huayuliang/TEMP_FILE/PannelInterface/GerberFiles_PIb/PannelInterface.png

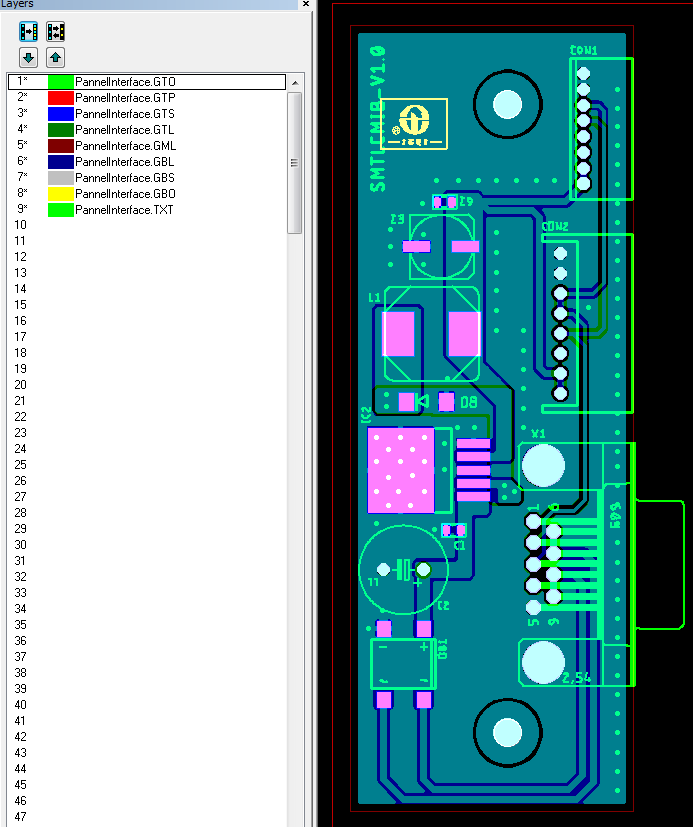
PannelInterface/GerberFiles_PIb/PannelInterface.png
