huayuliang/TEMP_FILE/BOM/BOM - 触摸屏转接适配板.xlsx

 | 造雪机触摸屏转接适配板 |  |  |  | 编制 | 花玉良 |  | 产品编号
 |  |  |  |  | 版本 | V1 |  | 产品名称
 |  |  |  |  | 日期 | 2017-10-12 |  | 产品型号 | SMTLCMIB
 |  |  |  |  | 客户
内部编号 | 零件名称 | 元件代号 | 型号、规格 | 封装 | 数量 | 单位 | 品牌 | 单价 | 备注
焊接物料 |  |  |  |  | 1 | 套
 | 表贴元件
 | 多层陶瓷电容 | C1、C9 | 100n/50V | C0805 | 2 | 个
 | 贴片电解电容 | C3 | 330uF/16V | 8X10 | 1 | 个
 | 整流桥 | DB1 | DB207S | DBS | 1 | 个
 | 功率电感 | L1 | 330uH/2A | RH127 | 1 | 个
 | 肖特基二极管 | D8 | SS24 | DO214AA | 1 | 个
 | DC/DC转换 | IC1 | LM2575D2T-012 | DDPAK-5 | 1 | 个
 | 直插元件
 | 电解电容 | C2 | 470uF/35V | 11x17 | 1 | 个
 | PH 连接器 | CON1 | PH-8AW 2.0mm 90度 8P | PH-8AW | 1 | 个
 | XH 连接器 | CON2 | XH-8AW 2.54mm 90度 8P | XH-8AW | 1 | 个
组装物料 |  |  |  |  | 1 | 套
 | PCB | SMTLCMIB | 36mm*100mm |  | 1 | pcs
 | 螺钉 |  | M3*··长度待定，缺资料 |  | 2 | 个
 |  |  |  |  |  | 个
 |  |  |  |  |  | 个
 |  |  |  |  |  | 个
