huayuliang/TEMP_FILE/BOM/BOM - 造雪机主控板.xlsx

 | 造雪机主控板 |  |  |  | 编制 | 花玉良 |  | 产品编号
 |  |  |  |  | 版本 | V1 |  | 产品名称
 |  |  |  |  | 日期 | 2017-10-12 |  | 产品型号 | SMMB
 |  |  |  |  | 客户
内部编号 | 零件名称 | 元件代号 | 型号、规格 | 封装 | 数量 | 单位 | 品牌 | 单价 | 备注
焊接物料 |  |  |  |  | 1 | 套
 | 表贴元件
 | 贴片多层陶瓷电容 | C1 | 1nF/2kV | C1206 | 1 | 个
 | 贴片多层陶瓷电容 | C4、C5 | 6.8nF/50V | C0603 | 2 | 个
 | 贴片多层陶瓷电容 | C8 | 22nF/50V | C0603 | 1 | 个
 | 贴片多层陶瓷电容 | C39、C44 | 6.8pF/50V/NP0 | C0603 | 2 | 个
 | 贴片多层陶瓷电容 | C27、C22、C47、C48 | 18pF/50V/NP0 | C0603 | 4 | 个
 | 贴片多层陶瓷电容 | C115、C116、C117、C118、C134、C135、C136、C137、C149、C150、C151、C152 | 30pF/50V | C0603 | 12 | 个
 | 贴片多层陶瓷电容 | C120、C121、C122、C123、C138、C139、C140、C141、C155、C156、C157、C158 | 1nF/50V | C0603 | 12 | 个
 | 贴片多层陶瓷电容 | C6、C15、C49、C50、C51、C52、C53、C54、C55、C56、C60、C61、C62、C63、C64、C65、C66、C67、C69、C70、C71、C72、C73、C74、C75、C76、C78、C79、C80、C81、C83、C84、C85、C86、C87、C88、C89、C90、C91、C93、C94、C95、C96、C97、C98、C99、C100、C101、C103 | 10nF/50V | C0603 | 49 | 个
 | 贴片多层陶瓷电容 | C2、C3、C9、C10、C11、C16、C17、C18、C24、C25、C26、C28、C29、C32、C33、C34、C35、C36、C37、C38、C43、C40、C41、C45、C46、C57、C58、C59、C68、C77、C104、C119、C127、C106、C108、C110、C111、C112、C113、C114、C129、C130、C131、C132、C133、C142、C145、C146、C147、C148、C153 | 100nF/50V | C0603 | 51 | 个
 | 贴片多层陶瓷电容 | C13 | 4.7uF/10V | C0603 | 1 | 个
 | 贴片多层陶瓷电容 | C7、C23、C30、C42、C105、C124、C154、C143 | 10uF/16V | C0603 | 8 | 个
 | 贴片铝电解 5X5 | C102、C144、C159、C125 | 47uF/6.3V 5x5.8 | UD-5X5,8_NICHICON | 4 | 个
 | 贴片铝电解 5X5 | C14、C12、C19、C20、C21、C31、C82、C92 | 100uF/6.3V 5x5.8 | UD-5X5,8_NICHICON | 8 | 个
 | 贴片铝电解 8X10 | EC1、EC2、EC3 | 220uF/50V | UD-8X10_NICHICON | 3 | 个
 | 贴片电阻 | R1、R18、R19、R20、R22 | 0R | R1206 | 5 | 个
 | 贴片电阻 | R10 | 10R | R0603 | 1 | 个
 | 贴片电阻 | R2、R5 | 22R | R0603 | 2 | 个
 | 贴片电阻 | R7、R8、R9、R11 | 49R9 | R0603 | 4 | 个
 | 贴片电阻 | R14、R15 | 2.4k | R0603 | 2 | 个
 | 贴片电阻 | R16 | 12.4k/1% | R0603 | 1 | 个
 | 贴片电阻 | R21 | 1M | R0603 | 1 | 个
 | 贴片电阻 | R3、R4、R24、R25、R40、R41、R42、R43、R44、R45、R46、R47、R56、R57、R58、R59、R60、R61、R62、R63、R72、R73、R74、R75、R76、R77、R78、R79 | 330R | R0603 | 11 | 个
 | 贴片电阻 | R34、R170、R171、R172、R173、R195、R196、R197、R198、R219、R220、R221、R222 | 1k | R0603 | 13 | 个
 | 贴片电阻 | R88、R89、R90、R91、R92、R93、R94、R95、R100、R101、R102、R103、R104、R105、R106、R107、R112、R113、R114、R115、R116、R117、R118、R119、R124、R125、R126、R127、R128、R129、R130、R131、R136、R137、R138、R139、R140、R141、R142、R143 | 2.2k | R1206 | 40 | 个
 | 贴片电阻 | R6、R17、R12、R23、R26、R27、R28、R29、R30、R31、R32、R33、R35、R36、R37、R38、R39、R96、R97、R98、R99、R108、R109、R110、R111、R120、R121、R122、R123、R132、R133、R134、R135、R144、R145、R146、R147、R148、R149、R154、R155、R156、R157、R179、R180、R181、R182、R203、R204、R205、R206 | 10k | R0603 | 51 | 个
 | 贴片电阻 | R48、R49、R50、R51、R52、R53、R54、R55、R64、R65、R66、R67、R68、R69、R70、R71、R80、R81、R82、R83、R84、R85、R86、R87、R174 | 20K | R0603 | 25 | 个
 | 贴片电阻 | R13 | 120R | R1206 | 1 | 个
 | 贴片电阻 | R150、R151、R152、R153、R175、R176、R177、R178、R199、R200、R201、R202 | 120R/0.1% | R1206 | 12 | 个
 | 贴片电阻 | R158、R159、R160、R161、R183、R184、R185、R186、R207、R208、R209、R210 | 5.11k/1% | R0603 | 12 | 个
 | 贴片电阻 | R166、R167、R168、R169、R191、R192、R193、R194、R215、R216、R217、R218 | 1k/1% | R0603 | 12 | 个
 | 贴片电阻 | R162、R163、R164、R165、R187、R188、R189、R190、R211、R212、R213、R214 | 124k/1% | R0603 | 12 | 个
 | 贴片磁珠 | L1、L2、L3、L4、L7 | 600R/100MHz | L0603 | 5 | 个
 | 贴片磁珠 | L5、L6、L10 | 100R/100MHz | L0805 | 3 | 个
 | 贴片电感 | L8、L9、L11、L12 | 10uH | L0603 | 4 | 个
 | 0805 贴片 LED | LED1 | 红色 0805 LED | LED0805 | 1 | 个
 |  | LED2、LED3 | 绿色 0805 LED | LED0805 | 2 | 个
 | 晶振 | XTAL1 | 25MHz | SM49 | 1 | 个
 | 晶振 | XTAL2 | MC-306 32.768000kHz 12.5 +20.0-20.0 | MC306 | 1 | 个
 | 晶振 | XTAL3 | 8MHz | SM49 | 1 | 个
 | TVS 管 | D1 | SM712-02H | SOT23-3 | 1 | 个
 | 开关二极管 | D2、D3、D4、D5、D6、D7、D8、D9、D10、D11、D12、D13、D14、D15、D16、D17、D18、D19、D20、D21、D23、D24、D25、D26、D27、D28、D29、D30、D32、D33、D34、D35 | 1N4148 | MINI_MELF(LL-34) | 32 | 个
 | 整流二极管 | D22、D31 | 1N4007 | SMA-DO214AC | 2 | 个
 | 贴片整流桥 | DB2 | KBP2005G | KBP2005 | 1 | 个
 | 四通道光耦 | OK1、OK2、OK3、OK4、OK5、OK6、OK7、OK8、OK9、OK10、OK11 | TLP283-4 | MINI-FLAT-16 | 11 | 个
 | RS232 收发 IC | IC1 | ST3232BD | SO16 | 1 | 个
 | RS485 收发 IC | IC2 | ST3485EBD | SO08 | 1 | 个
 | 以太网 IC | IC3 | W5500 | LQFP48_7X7_0.5P | 1 | 个
 | 实时时钟 IC | IC4 | SD2068 | SOIC-8 | 1 | 个
 | MCU | IC5 | STM32F103VCT6 | LQFP100_14X14MM | 1 | 个
 | 多路达林顿驱动IC | IC6、IC7、IC8 | ULN2803 | SO18W | 3 | 个
 | 基准电压源IC | IC9 | LM4040AIM3X-2.5 | SOT23-3 | 1 | 个
 | 3.3V稳压IC | IC10 | LM1117IDTX-3.3 | TO-252/DPAK | 1 | 个
 | R2R 四运放 | IC11、IC13、IC14、IC15 | SGM8584XS14 | SOIC-14 | 4 | 个
 | 蓝牙模块 | U1 | LQ-BTM2540 | LQ-BTM2540 | 1 | 个 | 蓝讯科技
 |  |  |  |  |  | 个
 | 直插元件
 | 24V 线性稳压IC | IC12 | LM78M24 | TO-220 | 1 | 个
 | 直插铝电解电容 | C109 | 220uF/16V_M10*16 | E3 | 1 | 个
 | 直插铝电解电容 | C107 | 1000uF/16V_M10*16 | E3 | 1 | 个
 | 直插铝电解电容 | C128 | 1000uF/35V_M10*16 | E3 | 1 | 个
 | 直插铝电解电容 | C126 | 2200uF/50V_M16*25 | E7 | 1 | 个
 | 120mA PPTC 保险丝 | F1、F2 | TRF250-120T |  | 2 | 个
 | 1A PPTC 保险丝 | F3、F4、F5 | RXEF110 |  | 3 | 个
 | TO-220 散热器（含螺丝） | HS1 | 23mm * 16.5mm * 30mm |  | 1 | 套
 | 电池 | BAT1 | CR2032/1HF | CR2032-HF | 1 | 个
 | 带变压器 RJ45 座 | CON1 | HR951180A |  | 1 | 个
 | 4Pin 排针 | CON2 | 4Pin 2.54mm 单排针 | PH2.54-4P | 1 | 个
 | 26Pin 牛角座 | CON3 | 26Pin 牛角座 | 26V | 1 | 个
 | DB9 母座 | X1 | SUB-D 母座 9P 180度 | F09VP | 1 | 个
 | 2Pin 绿色弹簧端子 | XT1、XT3、XT4 | FFKDS/V1-5.08-2 | FFKDS/V1-5.08-2 | 3 | 个
 | 2Pin 绿色弹簧端子 | XT2 | FFKDS/V1-5.08-3 | FFKDS/V1-5.08-3 | 1 | 个
 | 2Pin 绿色弹簧端子 |  | FFKDS/V1-5.08-24 | FFKDS/V1-5.08-24 | 1 | 个
 | 2Pin 绿色弹簧端子 |  | FFKDS/V1-5.08-12 | FFKDS/V1-5.08-12 | 2 | 个
 | 2Pin 绿色弹簧端子 |  | FFKDS/V1-5.08-40 | FFKDS/V1-5.08-40 | 1 | 个
组装物料 |  |  |  |  | 1 | 套
 | PCB | SMMB | 315mm*100mm |  | 1 | 个
70607030 | 自攻螺丝 |  | M3X16 |  | 3 | 个
70105006 | 绿色底板 |  | 宽度108.2mm 长315-2-2mm |  | 0.31 | 米
70608009 | 挡片(左) |  | 宽度108.2mm |  | 1 | 个
70608010 | 挡片(右) |  | 宽度108.2mm |  | 1 | 个
 | 控制变压器（需定制） |  | 输入电压：220V/380V；输出：绕组 1：5V/1A；绕组 2：24V/1.2A；绕组3：12V/1.2A |  | 1 | 个
 | 蓝牙天线及转接线 |  |  |  | 1 | 套 | 蓝讯科技
指定蓝讯科技
蓝牙模块链接：https://item.taobao.com/item.htm?spm=a1z10.3-c.w4002-12280541666.20.63236620KxYdoA&id=526084133471
蓝牙天线及转接线链接：https://item.taobao.com/item.htm?spm=2013.1.0.0.412946db8S2JxI&id=43386521334&tracelogww=ltckbburl
变压器不限厂家
变压器定制链接：https://item.taobao.com/item.htm?spm=a1z0d.7625083.1998302264.5.2df65bec2A1MDs&id=521838085399 或类似定制
