huayuliang/TEMP_FILE/snowmaker/SnowMaker_V1.0.pdf

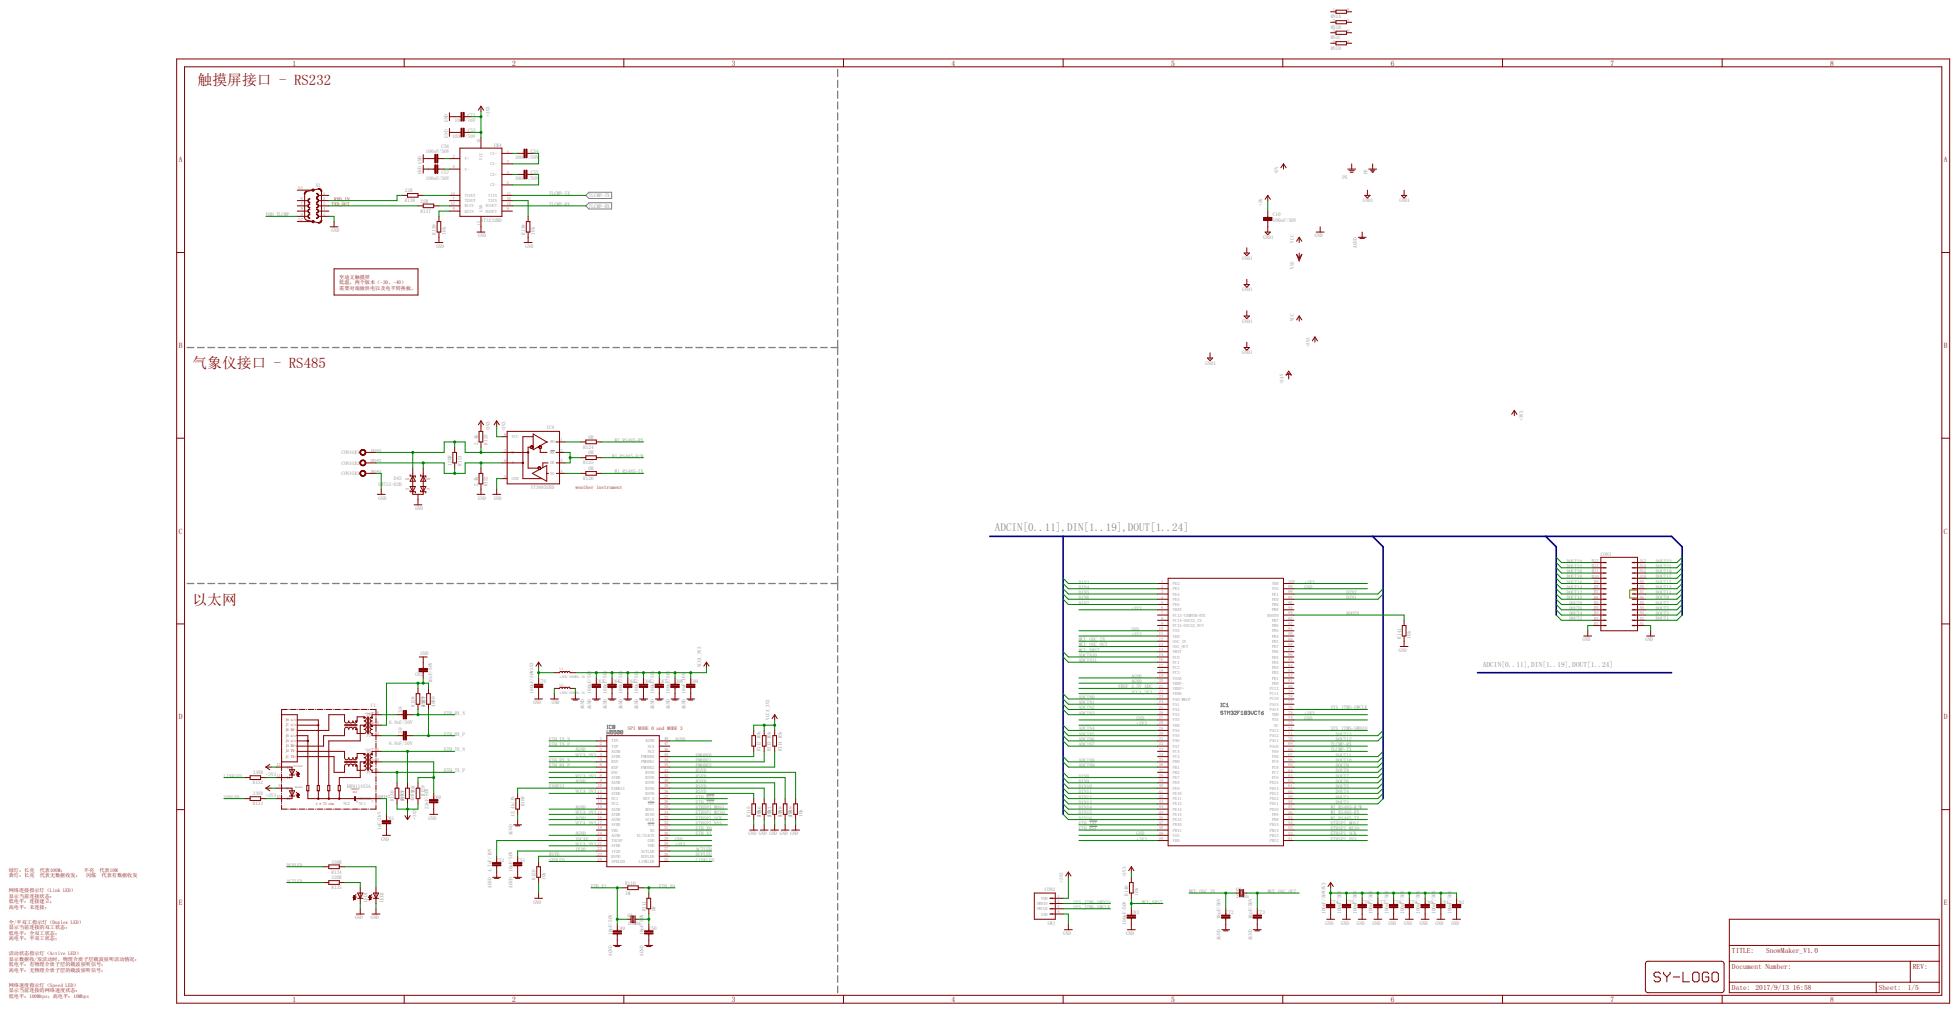
[picture p2: page 1]

VCCA_3V3 GND1 PE GND1 GND1 GND1 GND1 GND1 GND1 +3V3 VCC GND PE +24V 100nF/50V GND1 +5V HR911105A VSS VCC AGND AGND 12.4k/1% AGND 18pF/50V AGND AGND 18pF/50V 1M 0R 10nF/50V AGND 4.7uF/10V AGND 10k 10k 10k 10k GND GND GND GND GND 10k 10k 10k 10k 10k GND GND +3V3 120R ST3485EBD GND 2.4k 2.4k GND +3V3 SM712-02H GND 0R0R0R GND +3V3 6.8nF/50V 6.8nF/50V 22nF/50V 1nF/2kV GND 49R9 49R9 10R 49R9 10nF/50V GND 49R9 GND 330R 330R 330R +3V3 +3V3 330R GND GND 120R/100MHz 3A VCCA_3V3 100nF/50V AGND 100nF/50V AGND 100nF/50V AGND 100nF/50V AGND 100nF/50V AGND 100nF/50V AGND 10uF/16V AGND 100nF/50V+3V3 GND 25MHz 18pF/50V AGND AGND 18pF/50V25MHz 100nF/50V+3V3 GND 100nF/50V GND 100nF/50V GND 100nF/50V GND 100nF/50V GND 100nF/50V GND 100nF/50V GND 100nF/50V GND 100nF/50V GND 10k 100nF/50V GND +3V3 SWJ GND +3V3 10k GND 120R/100MHz 3A ST3232BD GND +3V3 +3V3 G100nF/50V ND 100nF/50V 100nF/50V 100nF/50V 100nF/50V GND GND 22R 22R 10k 10k GND GND G10uF/16V ND +5V GND GND GND PE2 1 PE3 2 PE4 3 PE5 4 PE6 5 VBAT 6 PC13-TAMPER-RTC 7 PC14-OSC32_IN 8 PC15-OSC32_OUT 9 VSS 10 VDD 11 OSC_IN 12 OSC_OUT 13 NRST 14 PC0 15 PC1 16 PC2 17 PC3 18 VSSA 19 VREF- 20 VREF+ 21 VDDA 22 PA0-WKUP 23 PA1 24 PA2 25 PA3 26 VSS 27 VDD 28 PA4 29 PA5 30 PA6 31 PA7 32 PC4 33 PC5 34 PB0 35 PB1 36 PB2 37 PE7 38 PE8 39 PE9 40 PE10 41 PE11 42 PE12 43 PE13 44 PE14 45 PE15 46 PB10 47 PB11 48 VSS 49 VDD 50 PB12 51 PB13 52 PB14 53 PB15 54 PD8 55 PD9 56 PD10 57 PD11 58 PD12 59 PD13 60 PD14 61 PD15 62 PC6 63 PC7 64 PC8 65 PC9 66 PA8 67 PA9 68 PA10 69 PA11 70 PA12 71 PA13 72 NC 73 VSS 74 VDD 75 PA14 76 PA15 77 PC10 78 PC11 79 PC12 80 PD0 81 PD1 82 PD2 83 PD3 84 PD4 85 PD5 86 PD6 87 PD7 88 PB3 89 PB4 90 PB5 91 PB6 92 PB7 93 BOOT0 94 PB8 95 PB9 96 PE0 97 PE1 98 VSS 99 VDD 100 C10 TXN 1 TXP 2 AGND 3 AVDD 4 RXN 5 RXP 6 DNC 7 AVDD 8 AGND 9 EXRES1 10 AVDD 11 NC1 12 NC2 13 AGND 14 AVDD 15 AGND 16 AVDD 17 VBG 18 AGND 19 TOCAP 20 AVDD 21 1V2O 22 RSVD 23 SPDLED 24 LINKLED 25 DUPLED 26 ACTLED 27 VDD 28 GND 29 XI/CLKIN 30 XO 31 SCS 32 SCLK 33 MISO 34 MOSI 35 INT 36 RST_N 37 RSVD 38 RSVD 39 RSVD 40 RSVD 41 RSVD 42 PMODE2 43 PMODE1 44 PMODE0 45 NC3 46 NC4 47 AGND 48 U1 P6 6 P5 5 P3 3 P2 2 P4 4 P1 1 SHIELD SS@1*2 10 10 9 9 11 11 12 12 NC1 7 NC2 8 R109 C49 C50 R110 R111 C52 C51 RN1A 1 8 RN1B 2 7 RN1C 3 6 RN1D 4 5 R112 R113 R114 R115 R116 R117 R118 R119 R120 R121 IC9 B 7 A 6 GND 5 VCC 8 RO 1 RE 2 DE 3 DI 4 CON1G$1 1@1*2 CON1G$2 2@1*2 CON1G$3 3@1*2 R122 R123 D45 R124 R125 R126 C58 C59 C60 C61 R127 R128 R129 R130 C62 R131 R132 R133 R134 R135 L1 C70 C63 C64 C65 C66 C67 C68 C69 LED1 LED2 Q1 C72 C73 Q2 C74 C75 C76 C77 C78 C79 C80 C81 C82 R140 C83 CON2 VDD 1 SWDIO 2 SWCLK 3 GND 4 R141 L2 U$4 C1+ 1 C1- 3 C2+ 4 C2- 5 T1IN 11 T2IN 10 R1OUT 12 R2OUT 9 V+ 2 V- 6 T1OUT 14 T2OUT 7 R1IN 13 R2IN 8 VCC 16 GND 15 C53 C54 C55 C56 C57 X1 1 6 2 7 3 8 4 9 5 G1G2 R136 R137 R138 R139 C71 CON3 A1A2A3A4A5 B1B2B3B4B5 A6A7A8A9A10 B6B7B8B9 B10 A11 A12 A13 B11 B12 B13 ADCIN[0..11],DIN[1..19],DOUT[1..24] ADCIN[0..11],DIN[1..19],DOUT[1..24] ETH_INT ETH_INT ETH_RST ETH_RST GND GND GNDGND GND GND ACTLED ACTLED DUPLED DUPLED LINKLED LINKLED SPDLED SPDLED 1V20 TOCAP PMODE0 PMODE1 PMODE2 AGND AGND AGND AGND AGND AGND AGND AGND EXRES1 +3V3 +3V3 +3V3 +3V3 +3V3 +3V3 +3V3 RSVD RSVD RSVD RSVD RSVD RSVD WI_RS485-R/W WI_RS485-R/W ETH_TX_P ETH_TX_P ETH_TX_N ETH_TX_N VCCA_3V3 VCCA_3V3 VCCA_3V3 VCCA_3V3 VCCA_3V3 VCCA_3V3 VCCA_3V3 ETH_RX_N ETH_RX_N ETH_RX_P ETH_RX_P ADCIN0 ADCIN1 ADCIN2 ADCIN3 ADCIN4 ADCIN5 ADCIN6 ADCIN7 ADCIN8 ADCIN9 ADCIN10 ADCIN11 ETHSPI_MOSI ETHSPI_MOSI ETHSPI_MISO ETHSPI_MISO ETHSPI_SCK ETHSPI_SCK ETHSPI_NSS ETHSPI_NSS VREF_2.5V_ADC ETH_XO ETH_XO ETH_XI ETH_XI MCU_OSC_IN MCU_OSC_IN MCU_OSC_OUT MCU_OSC_OUT MCU_NRST MCU_NRST SYS_JTMS-SWCLK SYS_JTMS-SWCLK DOUT2 DOUT2 DOUT3 DOUT3 DOUT4 DOUT4 DOUT5 DOUT5 DOUT7 DOUT7 DOUT8 DOUT8 DOUT9 DOUT9 DOUT10 DOUT10 DOUT11 DOUT11 DOUT12 DOUT12 SYS_JTMS-SWDIO SYS_JTMS-SWDIO DOUT6 DOUT6 DOUT13 DOUT13 BOOT0 TLCMP-RX TLCMP-RX TLCMP-RX DOUT1 DOUT14 DOUT16 DOUT15 DOUT18 DOUT17 DOUT20 DOUT19 DOUT22 DOUT21 DOUT24 DOUT23 WI_RS485-TX WI_RS485-TX WI_RS485-RX WI_RS485-RX DIN1 DIN2 DIN3 DIN4 DIN5 DIN6 DIN7 DIN8 DIN9 DIN10 DIN11 DIN12 DIN13 DIN14 DIN15 DIN16 TLCMP-TX TLCMP-TX TLCMP-TX VDD_TLCMP SPI MODE 0 and MODE 3 网络连接指示灯（Link LED） 显示当前连接状态： 低电平：连接建立； 高电平：未连接； 全/半双工指示灯（Duplex LED） 显示当前连接的双工状态： 低电平：全双工状态； 高电平：半双工状态； 活动状态指示灯（Active LED） 显示数据收/发活动时，物理介质子层载波侦听活动情况： 低电平：有物理介质子层的载波侦听信号； 高电平：无物理介质子层的载波侦听信号； 网络速度指示灯（Speed LED） 显示当前连接的网络速度状态： 低电平：100Mbps；高电平：10Mbps 绿灯：长亮 代表100M； 不亮 代表10M 黄灯：长亮 代表无数据收发； 闪烁 代表有数据收发 weather instrument 至迪文触摸屏 低温，两个版本（-30、-40） 需要对端做供电以及电平转换板。 RXD_IN TXD_OUT ABCDE 1 2 3 4 5 6 7 8 ABCDE 1 2 3 4 5 6 7 8 以太网 气象仪接口 - RS485 触摸屏接口 - RS232 1CT:1CT 1CT:1CT J8 n/c J7 n/c J6 RX- J5 n/c J4 n/c J3 RX+ J2 TX- J1 TX+ 4 * 75 ohm Yellow Green 1000pF 2kV R-R+T-T+ RCT TCT 12V 7V 12V 7V Date: 2017/9/13 16:58 Sheet: 1/5REV: TITLE: Document Number: SnowMaker_V1.0

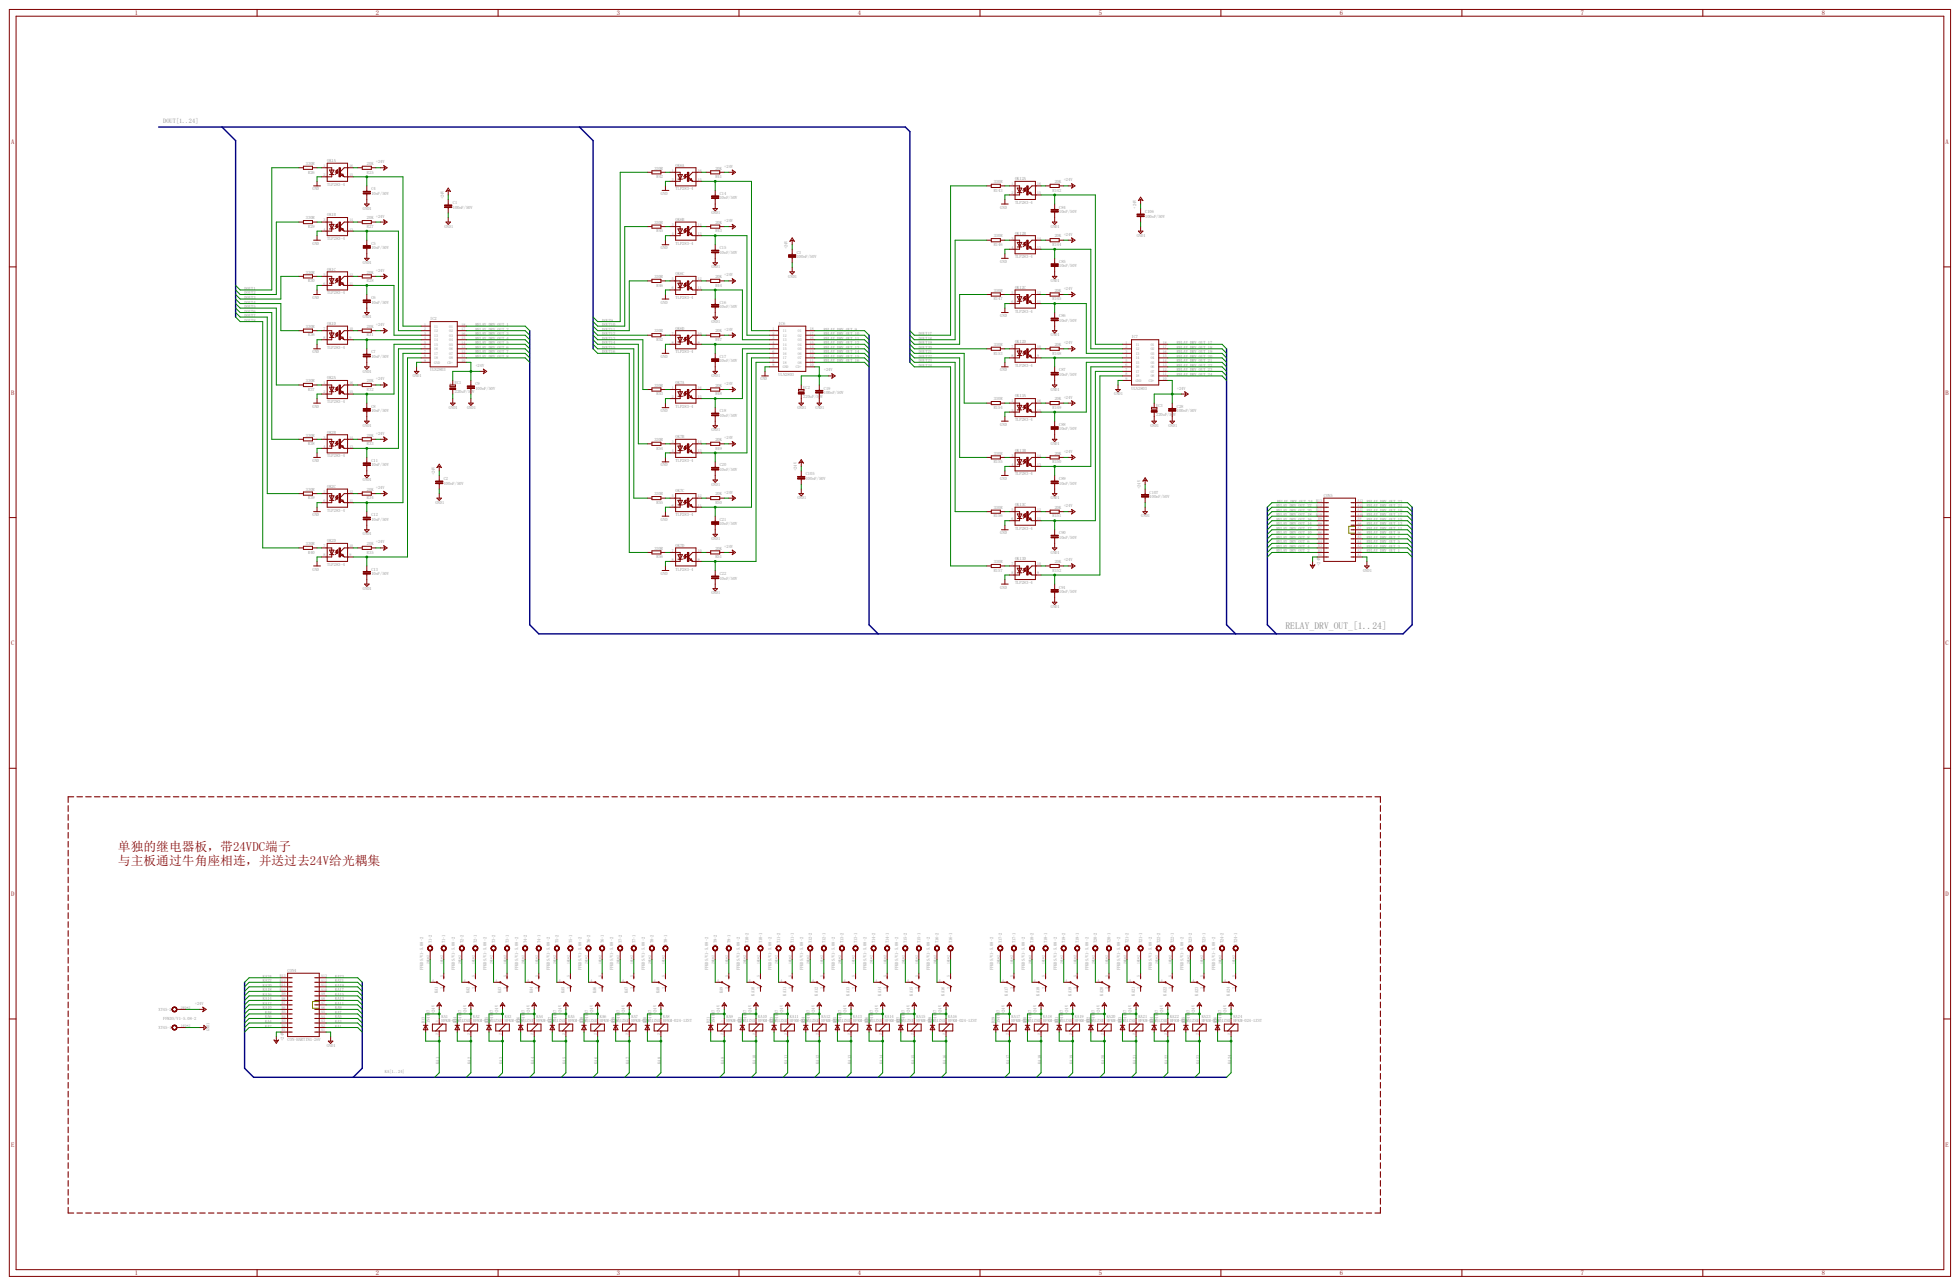
[picture p3: page 2]

RELAY_DRV_OUT_4 B3 RELAY_DRV_OUT_2 B2 | A3 RELAY_DRV_OUT_3 A2 RELAY_DRV_OUT_1

HFKM-024-1ZST HFKM-024-1ZST HFKM-024-1ZST HFKM-024-1ZST

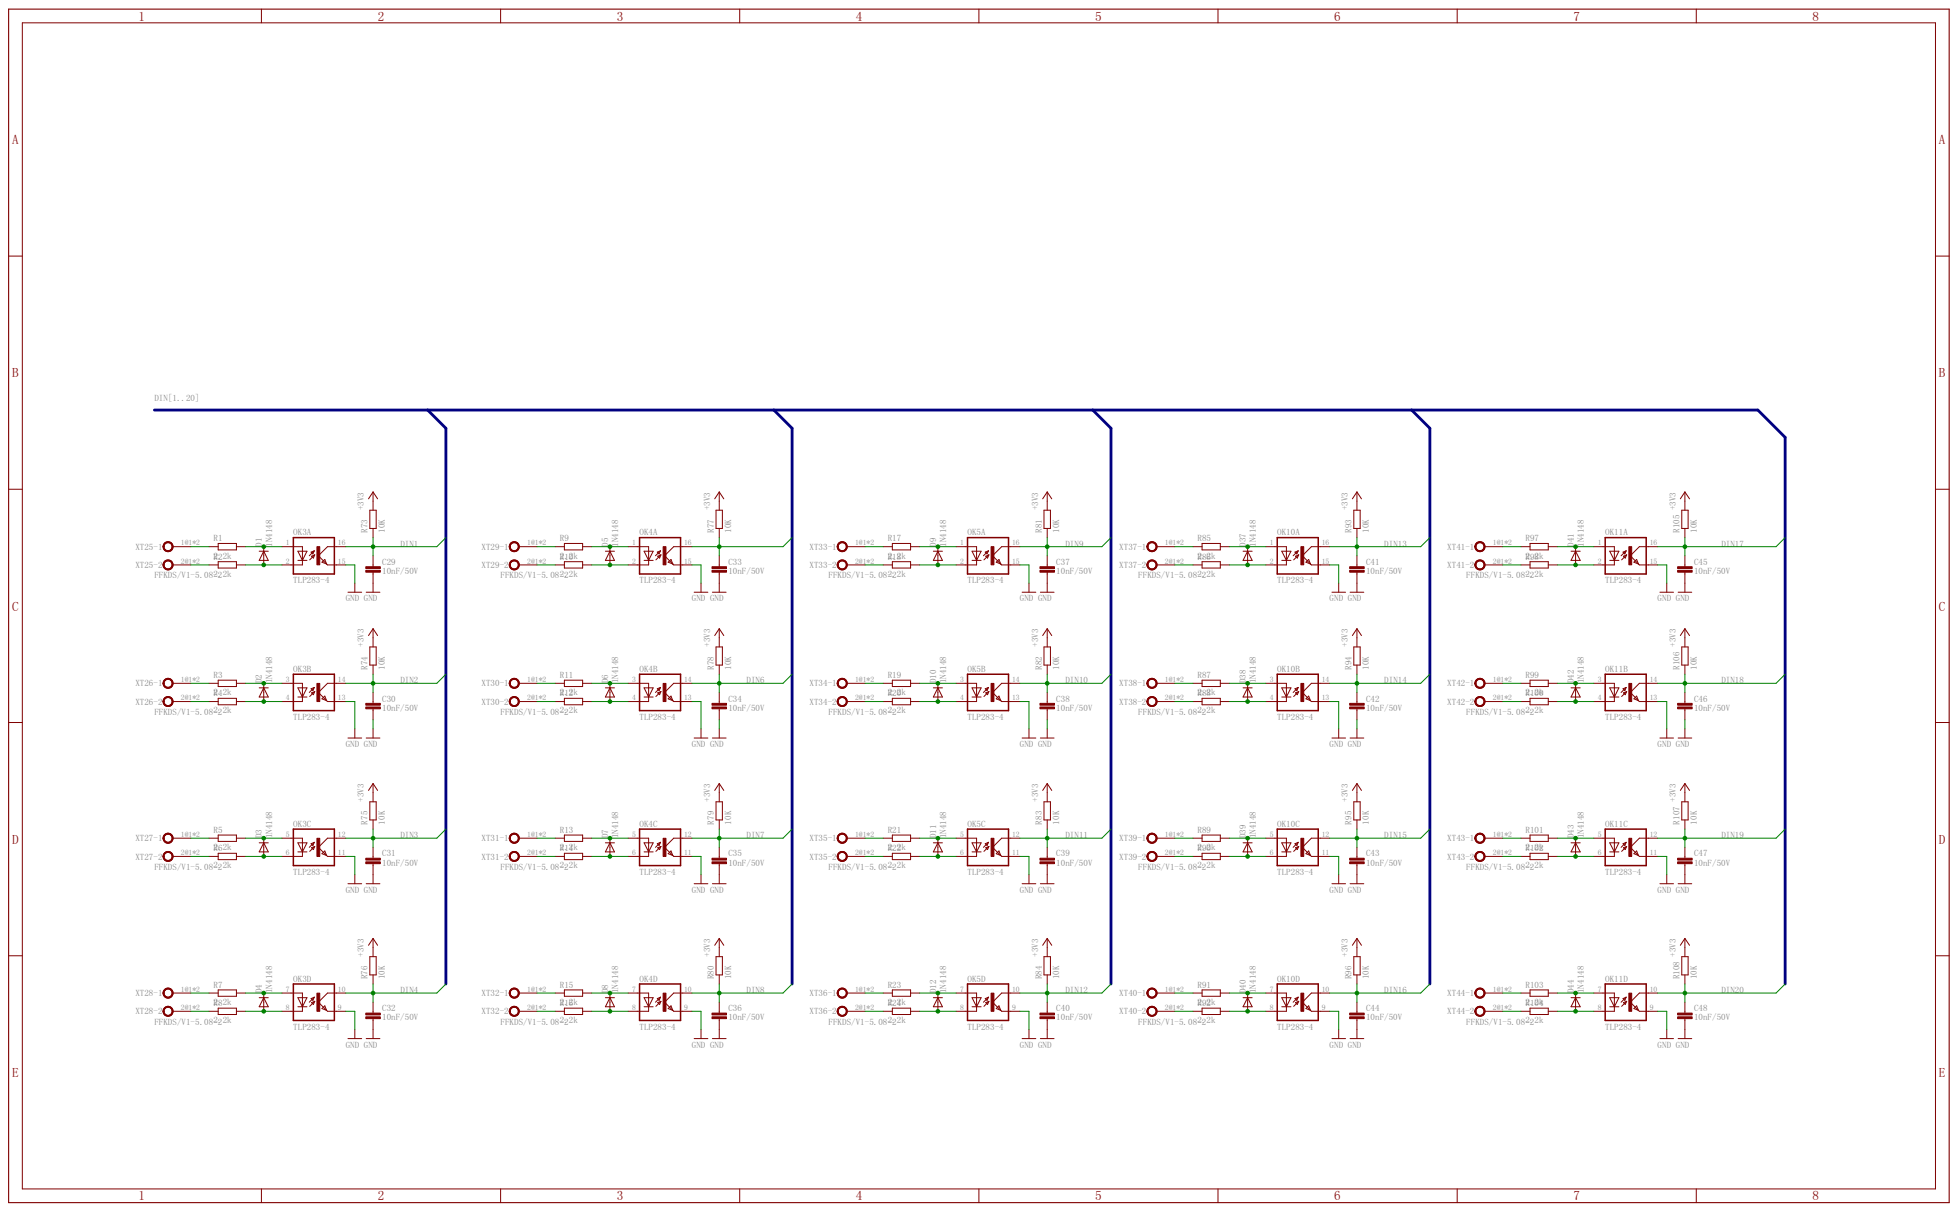
[picture p4: page 3]

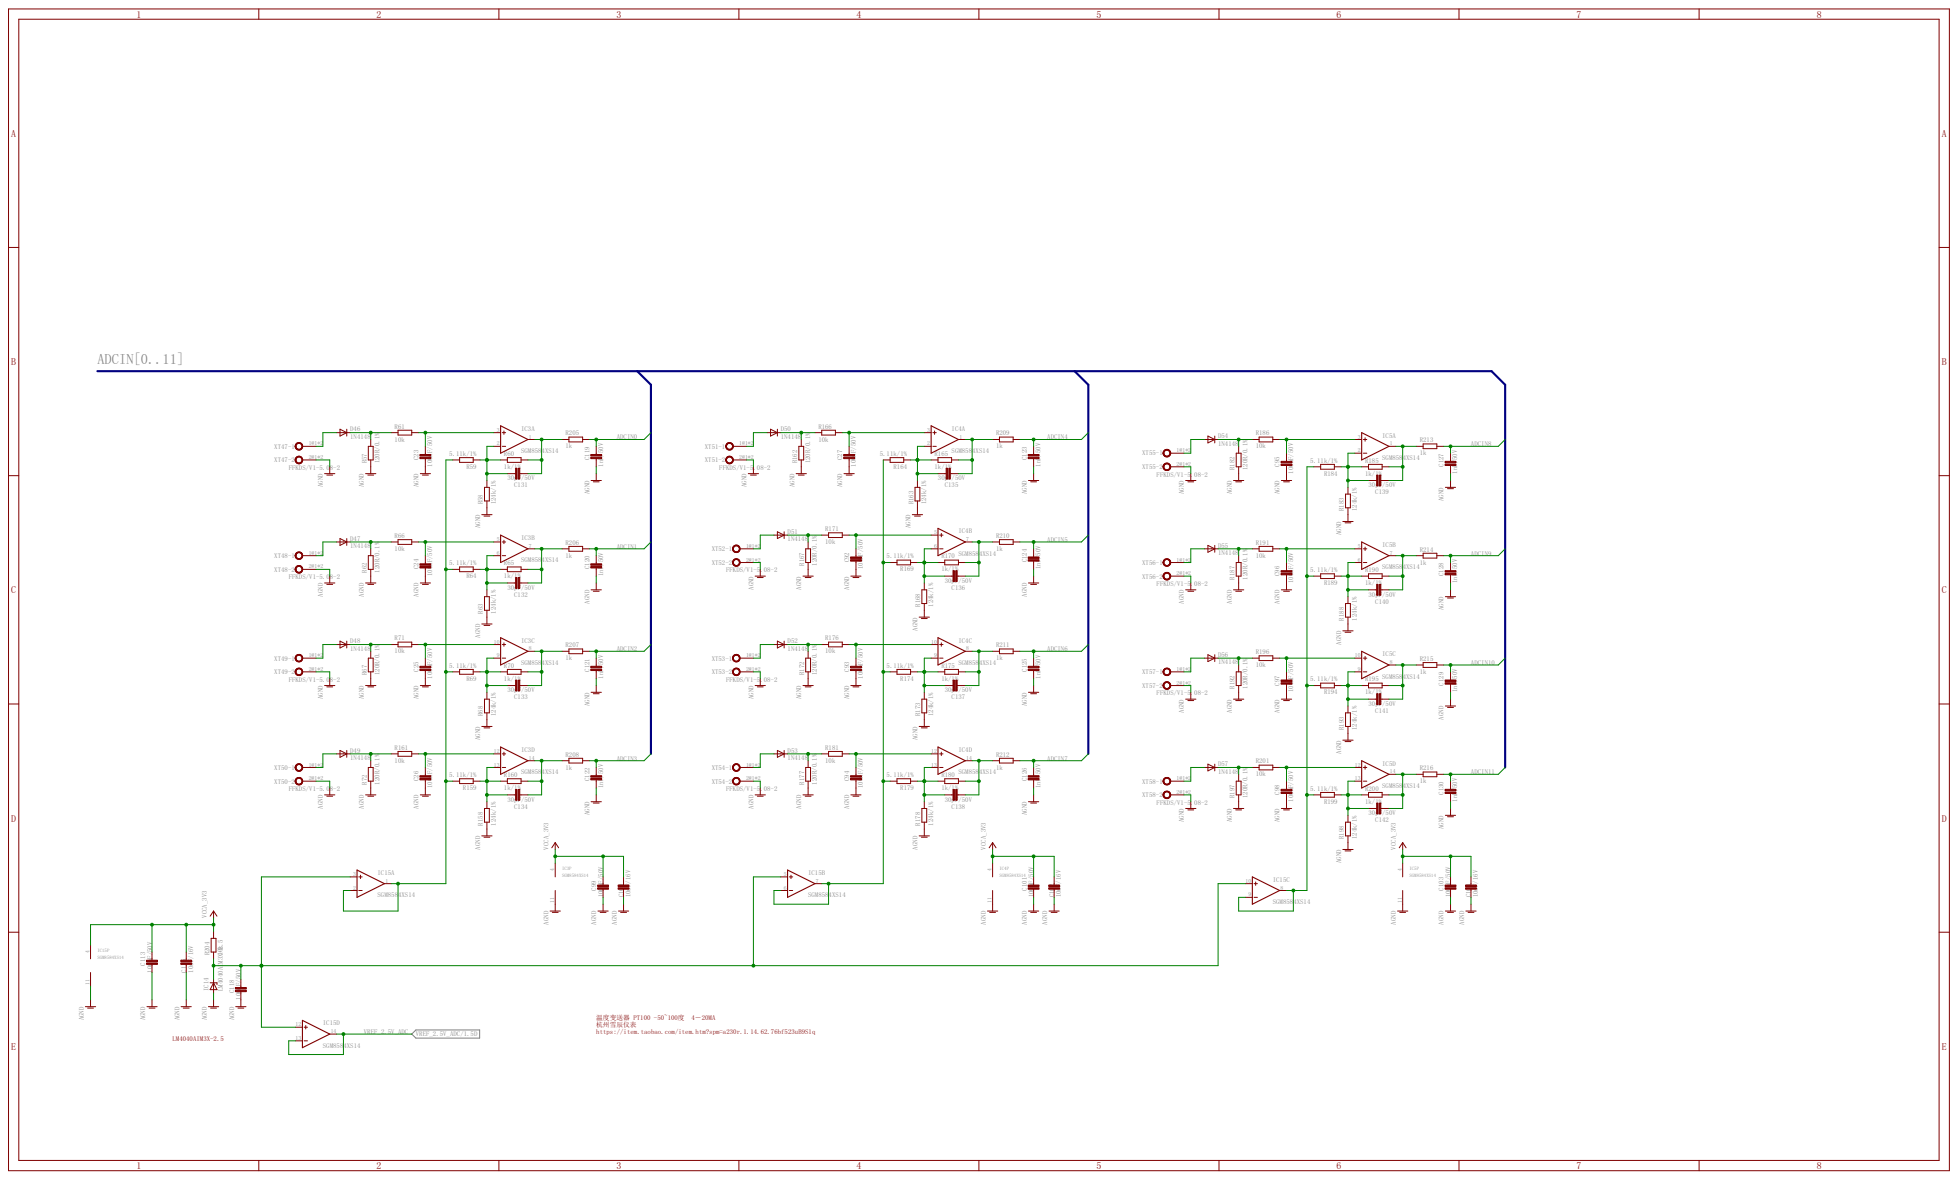
[picture p5: page 4]

https://item.taobao.com/item.htm?spm=a230r.1.14.62.76bf523uB9S1q

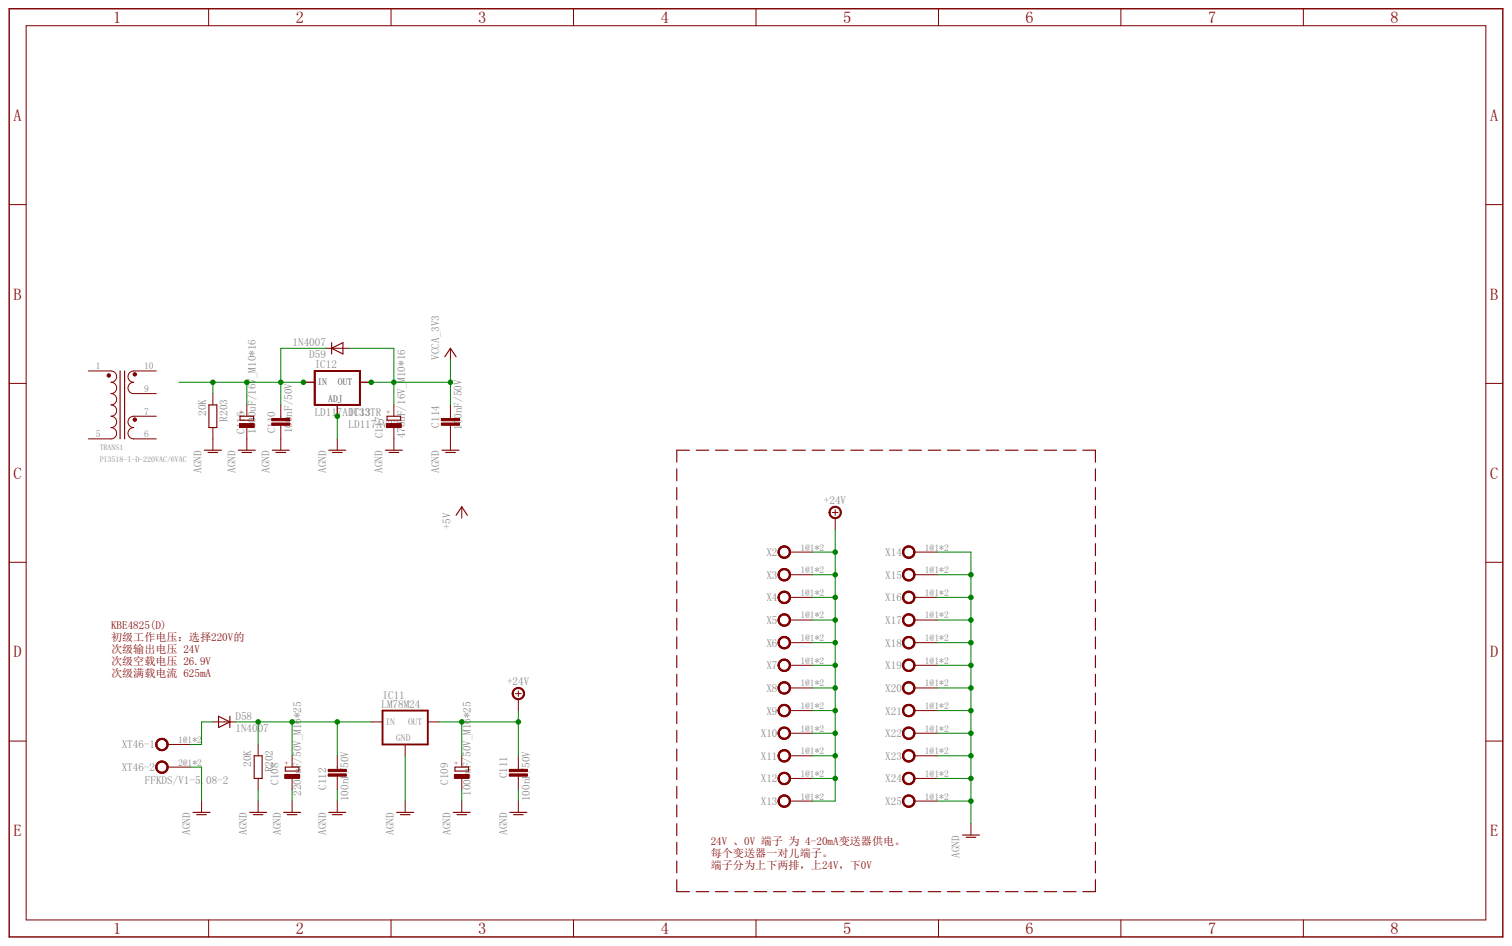
[picture p6: page 5]
