huayuliang/TEMP_FILE/snowmaker/GerberFiles_SnowMakerMainBoard_V1.0/SnowMaker_V1.0.TXT

%
M48
M72
T01C0.01575
T02C0.01772
T03C0.01969
T04C0.02362
T05C0.03200
T06C0.03346
T07C0.03504
T08C0.03600
T09C0.03937
T10C0.04000
T11C0.04016
T12C0.04331
T13C0.04724
T14C0.05118
T15C0.06417
T16C0.12598
T17C0.13000
%
T01
X70462Y163681
X72462Y167681
X70462Y171681
X76462Y171681
X78462Y167681
X81462Y163681
X85462Y163681
X89462Y164681
X84462Y167681
X81462Y171681
X85462Y173681
X90824Y170681
X90824Y177681
X80089Y183681
X77106Y181326
X73277Y181496
X73132Y177352
X75462Y163681
X134462Y172681
X446462Y240681
X456462Y239681
X466462Y239681
X476462Y239681
X486462Y239681
X520462Y245681
X546462Y240181
X550462Y247181
X559182Y251401
X562562Y253360
X566337Y253244
X567737Y257019
X569137Y260794
X570537Y264569
X573256Y267188
X576087Y264681
X577112Y260681
X578512Y256906
X598462Y256181
X599462Y252209
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
