huayuliang/TEMP_FILE/snowmaker/GerberFiles_SnowMakerMainBoard_V1.0/SnowMaker_V1.0.png

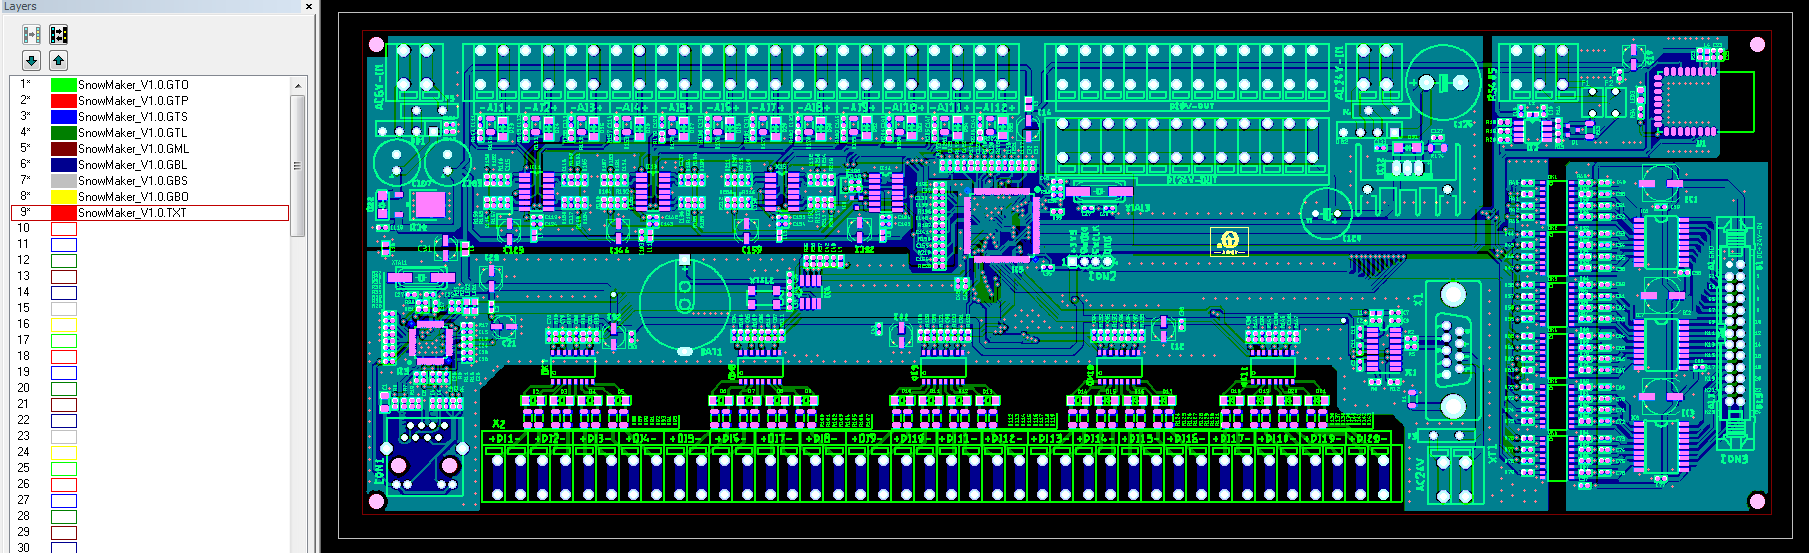
snowmaker/GerberFiles_SnowMakerMainBoard_V1.0/SnowMaker_V1.0.png
