huayuliang/TEMP_FILE/SnowMaker_RelayBoard/GerberFilse_SMRB-V1/SMRB-V1.png

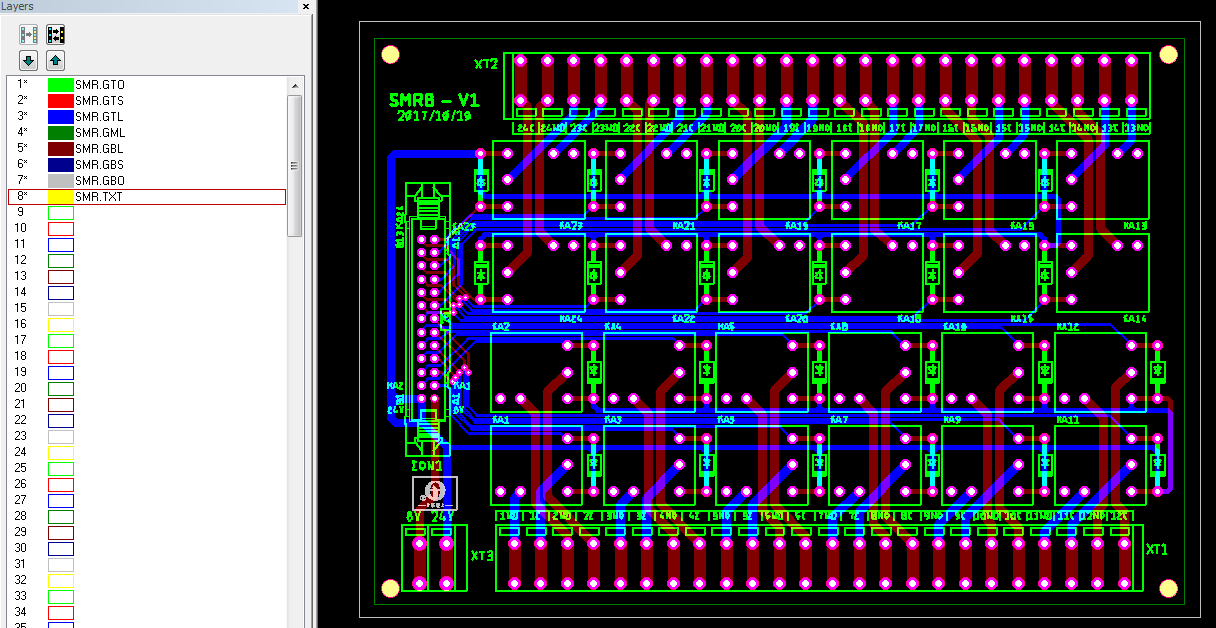
SnowMaker_RelayBoard/GerberFilse_SMRB-V1/SMRB-V1.png
