huayuliang/TEMP_FILE/DevTool/devtool.brd

## EAGLE design DevTool/devtool.brd (2017-10-18)

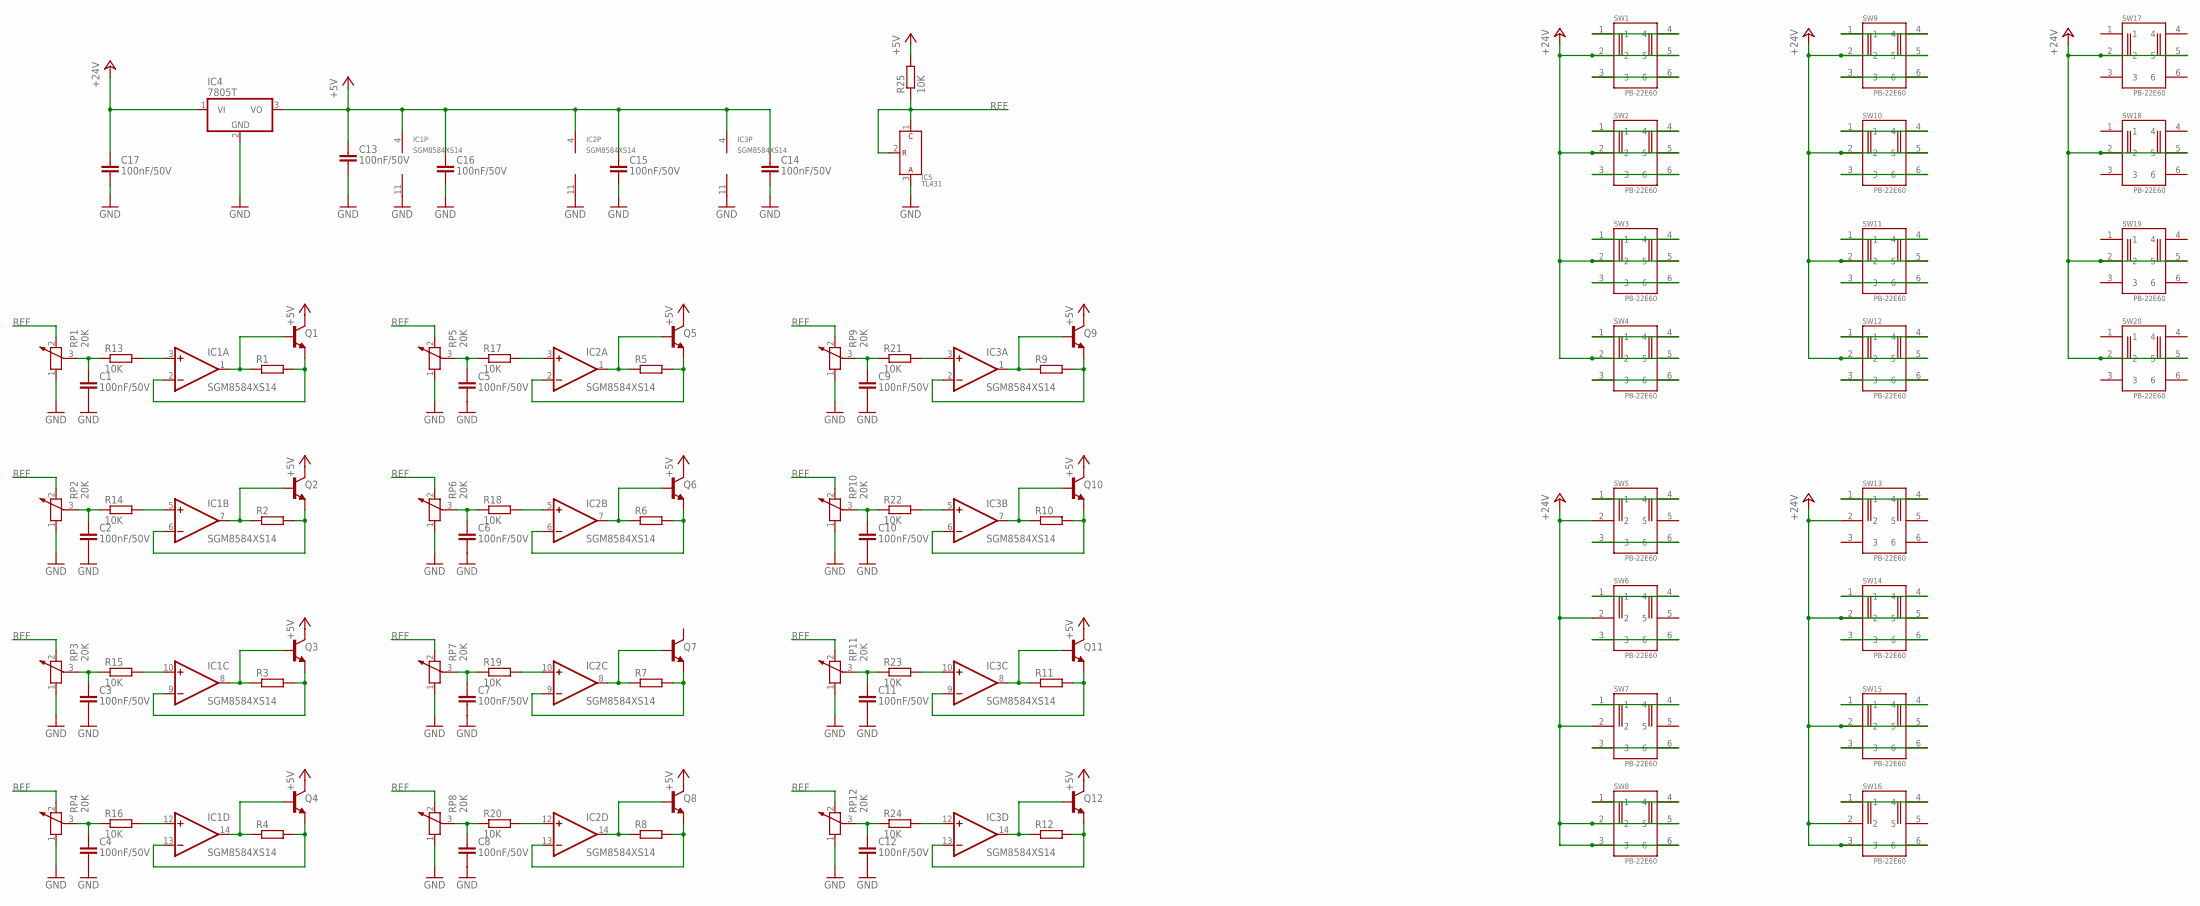
[picture p11: schematic devtool.sch]

Parts:
C1, C2, C3, C4, C5, C6, C7, C8, C9, C10, C11, C12, C13, C14, C15, C16, C17: 100nF/50V; C0603
IC1, IC2, IC3: SGM8584XS14; SOIC-14
IC4: 7805T; TO220H
IC5: TL431; SOT23-3
Q1, Q2, Q3, Q4, Q5, Q6, Q7, Q8, Q9, Q10, Q11, Q12: NPN; SOT23-BEC
R1, R2, R3, R4, R5, R6, R7, R8, R9, R10, R11, R12: R0603
R13, R14, R15, R16, R17, R18, R19, R20, R21, R22, R23, R24, R25: 10K; R0603
RP1, RP2, RP3, RP4, RP5, RP6, RP7, RP8, RP9, RP10, RP11, RP12: 20K; RM065
SW1, SW2, SW3, SW4, SW5, SW6, SW7, SW8, SW9, SW10, SW11, SW12, SW13, SW14, SW15, SW16, SW17, SW18, SW19, SW20: PB-22E60

Connections:
+5V: C13.1, C14.1, C15.1, C16.1, IC1.4 (V+), IC2.4 (V+), IC3.4 (V+), IC4.3 (VO), Q1.C, Q2.C, Q3.C, Q4.C, Q5.C, Q6.C, Q8.C, Q9.C, Q10.C, Q11.C, Q12.C, R25.2
+24V: C17.1, IC4.1 (VI), SW1.2, SW1.5, SW2.2, SW2.5, SW3.2, SW3.5, SW4.2, SW4.5, SW5.2, SW6.2, SW7.2, SW8.2, SW8.3, SW8.5, SW8.6, SW9.2, SW9.5, SW10.2, SW10.5, SW11.2, SW11.5, SW12.2, SW12.5, SW13.2, SW14.2, SW14.5, SW15.2, SW15.5, SW16.2, SW16.3, SW16.6, SW17.2, SW17.5, SW18.2, SW18.5, SW19.2, SW19.5, SW20.2, SW20.5
GND: C1.2, C2.2, C3.2, C4.2, C5.2, C6.2, C7.2, C8.2, C9.2, C10.2, C11.2, C12.2, C13.2, C14.2, C15.2, C16.2, C17.2, IC1.11 (V-), IC2.11 (V-), IC3.11 (V-), IC4.2 (GND), IC5.3 (A), RP1.1, RP2.1, RP3.1, RP4.1, RP5.1, RP6.1, RP7.1, RP8.1, RP9.1, RP10.1, RP11.1, RP12.1
unnamed: SW12.3, SW12.6
unnamed: IC1.1 (OUT), Q1.B, R1.1
unnamed: IC1.7 (OUT), Q2.B, R2.1
unnamed: IC1.8 (OUT), Q3.B, R3.1
unnamed: IC1.14 (OUT), Q4.B, R4.1
unnamed: IC2.1 (OUT), Q5.B, R5.1
unnamed: IC2.7 (OUT), Q6.B, R6.1
unnamed: IC2.8 (OUT), Q7.B, R7.1
unnamed: IC2.14 (OUT), Q8.B, R8.1
unnamed: IC3.1 (OUT), Q9.B, R9.1
unnamed: IC3.7 (OUT), Q10.B, R10.1
unnamed: IC3.8 (OUT), Q11.B, R11.1
unnamed: IC3.14 (OUT), Q12.B, R12.1
unnamed: IC1.2 (-IN), Q1.E, R1.2
unnamed: IC3.13 (-IN), Q12.E, R12.2
unnamed: IC3.9 (-IN), Q11.E, R11.2
unnamed: IC3.6 (-IN), Q10.E, R10.2
unnamed: IC3.2 (-IN), Q9.E, R9.2
unnamed: IC1.6 (-IN), Q2.E, R2.2
unnamed: IC1.9 (-IN), Q3.E, R3.2
unnamed: IC1.13 (-IN), Q4.E, R4.2
unnamed: IC2.2 (-IN), Q5.E, R5.2
unnamed: IC2.6 (-IN), Q6.E, R6.2
unnamed: IC2.9 (-IN), Q7.E, R7.2
unnamed: IC2.13 (-IN), Q8.E, R8.2
unnamed: SW14.3, SW14.6
unnamed: SW14.1, SW14.4
unnamed: SW13.1, SW13.4
unnamed: SW15.1, SW15.4
unnamed: SW15.3, SW15.6
unnamed: SW16.1, SW16.4
unnamed: SW8.1, SW8.4
unnamed: SW7.3, SW7.6
unnamed: SW7.1, SW7.4
unnamed: SW6.3, SW6.6
unnamed: SW6.1, SW6.4
unnamed: SW5.3, SW5.6
unnamed: SW5.1, SW5.4
unnamed: SW4.3, SW4.6
unnamed: SW4.1, SW4.4
unnamed: SW3.1, SW3.4
unnamed: SW3.3, SW3.6
unnamed: SW2.1, SW2.4
unnamed: SW2.3, SW2.6
unnamed: SW1.3, SW1.6
unnamed: SW1.1, SW1.4
unnamed: SW9.1, SW9.4
unnamed: SW9.3, SW9.6
unnamed: SW10.1, SW10.4
unnamed: SW10.3, SW10.6
unnamed: SW11.1, SW11.4
unnamed: SW11.3, SW11.6
unnamed: SW12.1, SW12.4
unnamed: C1.1, R13.1, RP1.3
unnamed: C2.1, R14.1, RP2.3
unnamed: C3.1, R15.1, RP3.3
unnamed: C4.1, R16.1, RP4.3
unnamed: C5.1, R17.1, RP5.3
unnamed: C6.1, R18.1, RP6.3
unnamed: C7.1, R19.1, RP7.3
unnamed: C8.1, R20.1, RP8.3
unnamed: C9.1, R21.1, RP9.3
unnamed: C10.1, R22.1, RP10.3
unnamed: C11.1, R23.1, RP11.3
unnamed: C12.1, R24.1, RP12.3
unnamed: IC1.3 (+IN), R13.2
unnamed: IC1.5 (+IN), R14.2
unnamed: IC1.10 (+IN), R15.2
unnamed: IC1.12 (+IN), R16.2
unnamed: IC2.12 (+IN), R20.2
unnamed: IC2.10 (+IN), R19.2
unnamed: IC2.5 (+IN), R18.2
unnamed: IC2.3 (+IN), R17.2
unnamed: IC3.3 (+IN), R21.2
unnamed: IC3.5 (+IN), R22.2
unnamed: IC3.10 (+IN), R23.2
unnamed: IC3.12 (+IN), R24.2
REF: IC5.1 (C), IC5.2 (REF), R25.1, RP1.2, RP2.2, RP3.2, RP4.2, RP5.2, RP6.2, RP7.2, RP8.2, RP9.2, RP10.2, RP11.2, RP12.2

Board: 2 copper layers, 91 parts (0 on the bottom side), 81 nets, no tracks yet.
