huayuliang/TEMP_FILE/PannelInterface/PannelInterface.brd

## EAGLE design PannelInterface/PannelInterface.brd (2017-10-12)

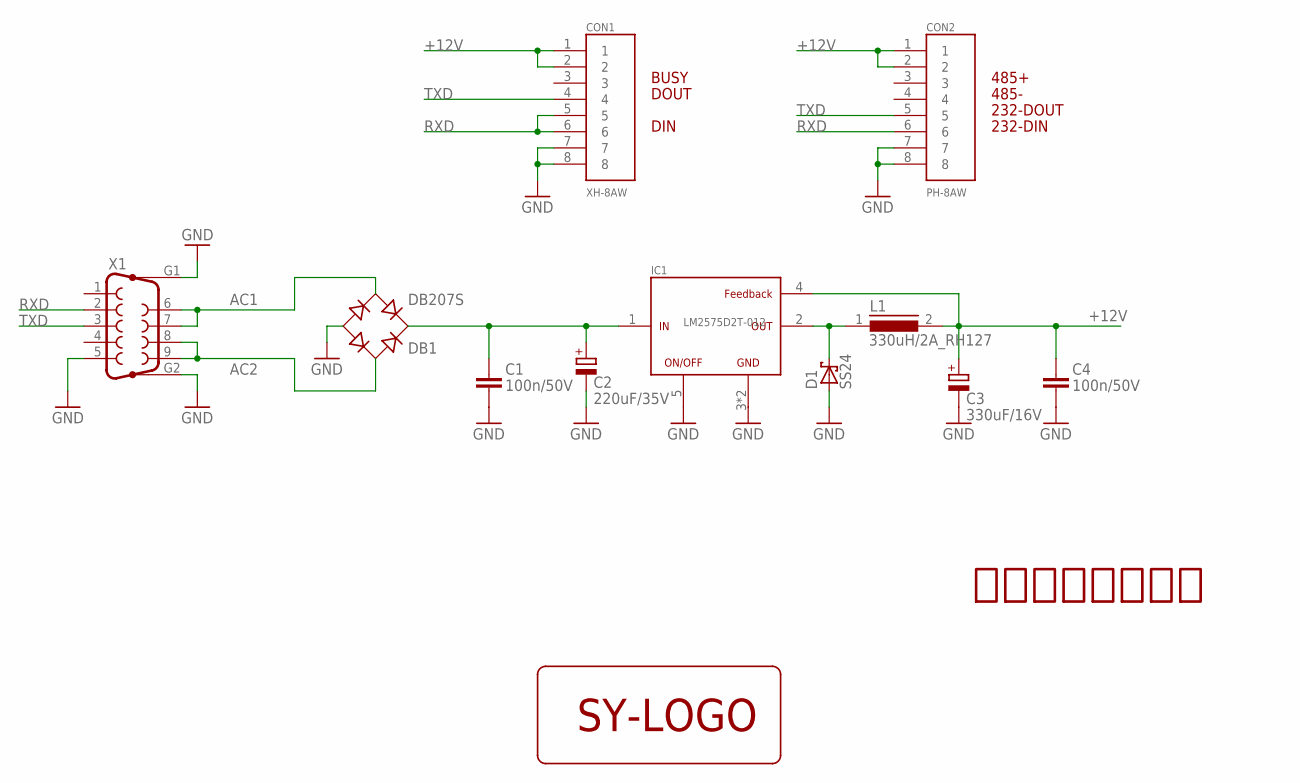
[picture p12: schematic PannelInterface.sch]

Parts:
C1, C4: 100n/50V; C0805
C2: 220uF/35V; TT5D11
C3: 330uF/16V; UD-8X10_NICHICON
CON1: XH-8AW
CON2: PH-8AW
D1: SS24; DO214AA
DB1: DB207S; DBS
IC1: LM2575D2T-012; DDPAK-5_MICROCHIP
L1: 330uH/2A_RH127; MSS1260
LOGO1: SY-LOGO_BOTTOM
X1: F09HP

Connections:
+12V: C3.+, C4.1, CON1.1, CON1.2, CON2.1, CON2.2, IC1.4, L1.2
AC1: DB1.AC2, X1.6, X1.7
AC2: DB1.AC1, X1.8, X1.9
GND: C1.2, C2.-, C3.-, C4.2, CON1.7, CON1.8, CON2.7, CON2.8, D1.A, DB1.-, IC1.3, IC1.5, IC1.6 (3), X1.5, X1.G1, X1.G2
unnamed: C1.1, C2.+, DB1.+, IC1.1
unnamed: D1.C, IC1.2, L1.1
RXD: CON1.5, CON1.6, CON2.6, X1.2
TXD: CON1.4, CON2.5, X1.3

Notes on the sheet:
DIN
DOUT
232-DOUT
232-DIN
485+
485-
BUSY
触摸屏转接适配板

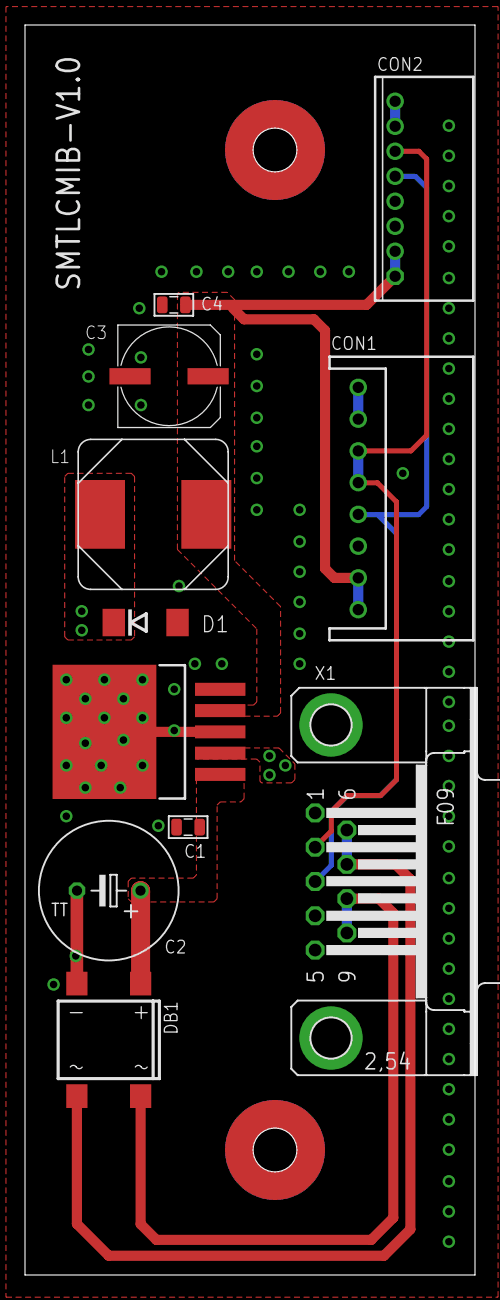
[picture p13: board PannelInterface.brd from above]

Board: 2 copper layers, 36.0 x 100.0 mm, 13 parts (0 on the bottom side), 8 nets.

Other parts of the board:
U$1: PANNEL-INTERFACE-OUTLINE
