huayuliang/TEMP_FILE/SnowMaker_RelayBoard/SMR.brd

## EAGLE design SnowMaker_RelayBoard/SMR.brd (2017-10-10)

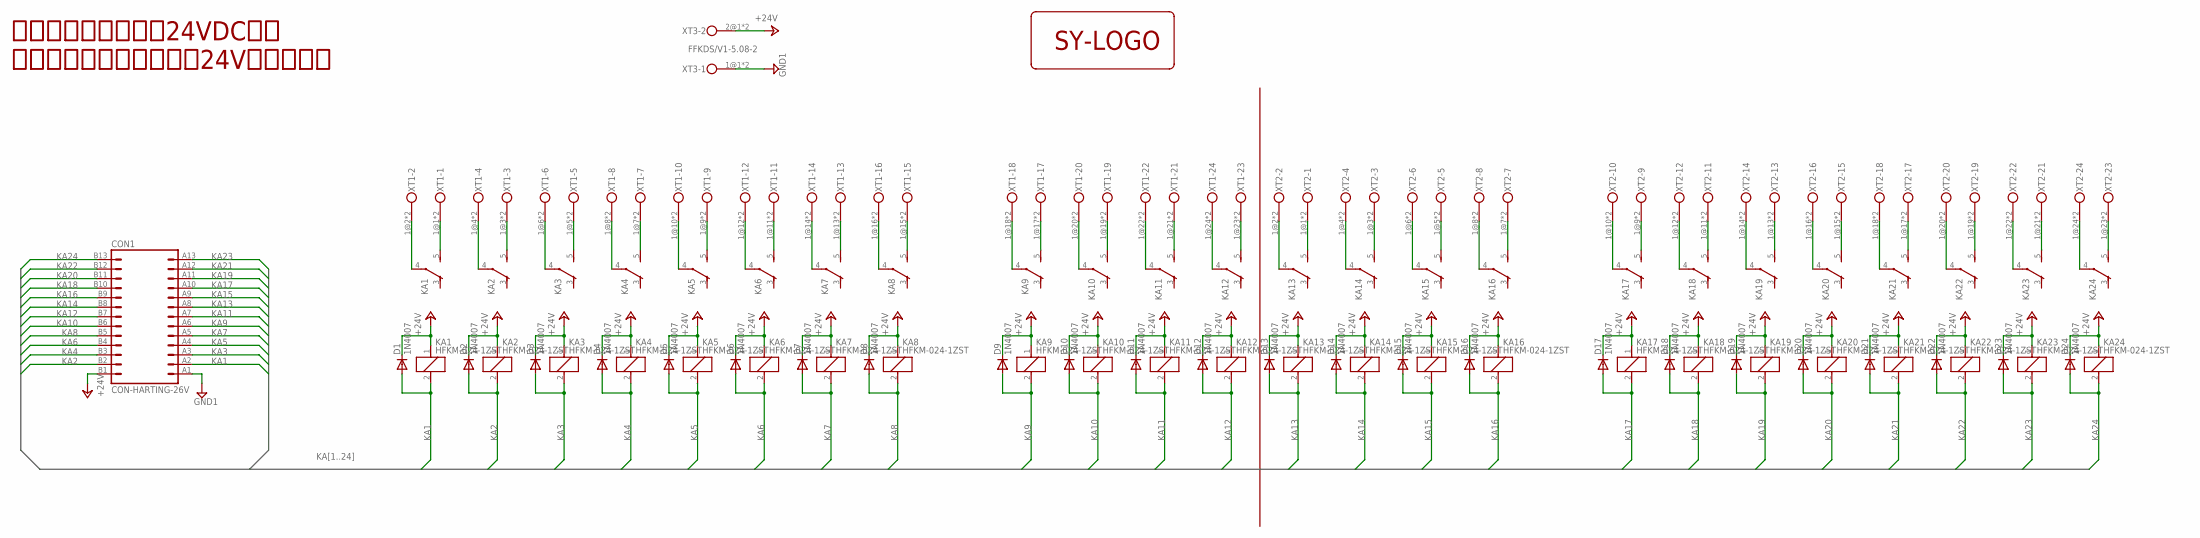
[picture p22: schematic SMR.sch]

Parts:
CON1: CON-HARTING-26V; 26V
D1, D2, D3, D4, D5, D6, D7, D8, D9, D10, D11, D12, D13, D14, D15, D16, D17, D18, D19, D20, D21, D22, D23, D24: 1N4007; DO41-10
KA1, KA2, KA3, KA4, KA5, KA6, KA7, KA8, KA9, KA10, KA11, KA12, KA13, KA14, KA15, KA16, KA17, KA18, KA19, KA20, KA21, KA22, KA23, KA24: HFKM-024-1ZST; HFKM-1ZST
LOGO1: SY-LOGO_BOTTOM
XT1, XT2: FFKDS/V1-5.08-24
XT3: FFKDS/V1-5.08-2

Connections:
+24V: CON1.B1, D1.C, D2.C, D3.C, D4.C, D5.C, D6.C, D7.C, D8.C, D9.C, D10.C, D11.C, D12.C, D13.C, D14.C, D15.C, D16.C, D17.C, D18.C, D19.C, D20.C, D21.C, D22.C, D23.C, D24.C, KA1.1 (COIL1), KA2.1 (COIL1), KA3.1 (COIL1), KA4.1 (COIL1), KA5.1 (COIL1), KA6.1 (COIL1), KA7.1 (COIL1), KA8.1 (COIL1), KA9.1 (COIL1), KA10.1 (COIL1), KA11.1 (COIL1), KA12.1 (COIL1), KA13.1 (COIL1), KA14.1 (COIL1), KA15.1 (COIL1), KA16.1 (COIL1), KA17.1 (COIL1), KA18.1 (COIL1), KA19.1 (COIL1), KA20.1 (COIL1), KA21.1 (COIL1), KA22.1 (COIL1), KA23.1 (COIL1), KA24.1 (COIL1), XT3.2@1, XT3.2@2
GND1: CON1.A1, XT3.1@1, XT3.1@2
KA1: CON1.A2, D1.A, KA1.2 (COIL2)
KA2: CON1.B2, D2.A, KA2.2 (COIL2)
KA3: CON1.A3, D3.A, KA3.2 (COIL2)
KA4: CON1.B3, D4.A, KA4.2 (COIL2)
KA5: CON1.A4, D5.A, KA5.2 (COIL2)
KA6: CON1.B4, D6.A, KA6.2 (COIL2)
KA7: CON1.A5, D7.A, KA7.2 (COIL2)
KA8: CON1.B5, D8.A, KA8.2 (COIL2)
KA9: CON1.A6, D9.A, KA9.2 (COIL2)
KA10: CON1.B6, D10.A, KA10.2 (COIL2)
KA11: CON1.A7, D11.A, KA11.2 (COIL2)
KA12: CON1.B7, D12.A, KA12.2 (COIL2)
KA13: CON1.A8, D13.A, KA13.2 (COIL2)
KA14: CON1.B8, D14.A, KA14.2 (COIL2)
KA15: CON1.A9, D15.A, KA15.2 (COIL2)
KA16: CON1.B9, D16.A, KA16.2 (COIL2)
KA17: CON1.A10, D17.A, KA17.2 (COIL2)
KA18: CON1.B10, D18.A, KA18.2 (COIL2)
KA19: CON1.A11, D19.A, KA19.2 (COIL2)
KA20: CON1.B11, D20.A, KA20.2 (COIL2)
KA21: CON1.A12, D21.A, KA21.2 (COIL2)
KA22: CON1.B12, D22.A, KA22.2 (COIL2)
KA23: CON1.A13, D23.A, KA23.2 (COIL2)
KA24: CON1.B13, D24.A, KA24.2 (COIL2)
unnamed: KA1.4 (COM), XT1.1@2, XT1.2@2
unnamed: KA1.5 (NO), XT1.1@1, XT1.2@1
unnamed: KA3.4 (COM), XT1.1@6, XT1.2@6
unnamed: KA3.5 (NO), XT1.1@5, XT1.2@5
unnamed: KA8.5 (NO), XT1.1@15, XT1.2@15
unnamed: KA8.4 (COM), XT1.1@16, XT1.2@16
unnamed: KA7.5 (NO), XT1.1@13, XT1.2@13
unnamed: KA7.4 (COM), XT1.1@14, XT1.2@14
unnamed: KA6.5 (NO), XT1.1@11, XT1.2@11
unnamed: KA6.4 (COM), XT1.1@12, XT1.2@12
unnamed: KA5.5 (NO), XT1.1@9, XT1.2@9
unnamed: KA5.4 (COM), XT1.1@10, XT1.2@10
unnamed: KA4.5 (NO), XT1.1@7, XT1.2@7
unnamed: KA4.4 (COM), XT1.1@8, XT1.2@8
unnamed: KA2.5 (NO), XT1.1@3, XT1.2@3
unnamed: KA2.4 (COM), XT1.1@4, XT1.2@4
unnamed: KA9.4 (COM), XT1.1@18, XT1.2@18
unnamed: KA9.5 (NO), XT1.1@17, XT1.2@17
unnamed: KA16.5 (NO), XT2.1@7, XT2.2@7
unnamed: KA16.4 (COM), XT2.1@8, XT2.2@8
unnamed: KA15.5 (NO), XT2.1@5, XT2.2@5
unnamed: KA15.4 (COM), XT2.1@6, XT2.2@6
unnamed: KA14.5 (NO), XT2.1@3, XT2.2@3
unnamed: KA14.4 (COM), XT2.1@4, XT2.2@4
unnamed: KA13.5 (NO), XT2.1@1, XT2.2@1
unnamed: KA13.4 (COM), XT2.1@2, XT2.2@2
unnamed: KA12.5 (NO), XT1.1@23, XT1.2@23
unnamed: KA12.4 (COM), XT1.1@24, XT1.2@24
unnamed: KA11.5 (NO), XT1.1@21, XT1.2@21
unnamed: KA11.4 (COM), XT1.1@22, XT1.2@22
unnamed: KA10.5 (NO), XT1.1@19, XT1.2@19
unnamed: KA10.4 (COM), XT1.1@20, XT1.2@20
unnamed: KA17.4 (COM), XT2.1@10, XT2.2@10
unnamed: KA17.5 (NO), XT2.1@9, XT2.2@9
unnamed: KA24.5 (NO), XT2.1@23, XT2.2@23
unnamed: KA24.4 (COM), XT2.1@24, XT2.2@24
unnamed: KA23.5 (NO), XT2.1@21, XT2.2@21
unnamed: KA23.4 (COM), XT2.1@22, XT2.2@22
unnamed: KA22.5 (NO), XT2.1@19, XT2.2@19
unnamed: KA22.4 (COM), XT2.1@20, XT2.2@20
unnamed: KA21.5 (NO), XT2.1@17, XT2.2@17
unnamed: KA21.4 (COM), XT2.1@18, XT2.2@18
unnamed: KA20.5 (NO), XT2.1@15, XT2.2@15
unnamed: KA20.4 (COM), XT2.1@16, XT2.2@16
unnamed: KA19.5 (NO), XT2.1@13, XT2.2@13
unnamed: KA19.4 (COM), XT2.1@14, XT2.2@14
unnamed: KA18.5 (NO), XT2.1@11, XT2.2@11
unnamed: KA18.4 (COM), XT2.1@12, XT2.2@12

Notes on the sheet:
单独的继电器板，带24VDC端子 与主板通过牛角座相连，24V给光耦供电

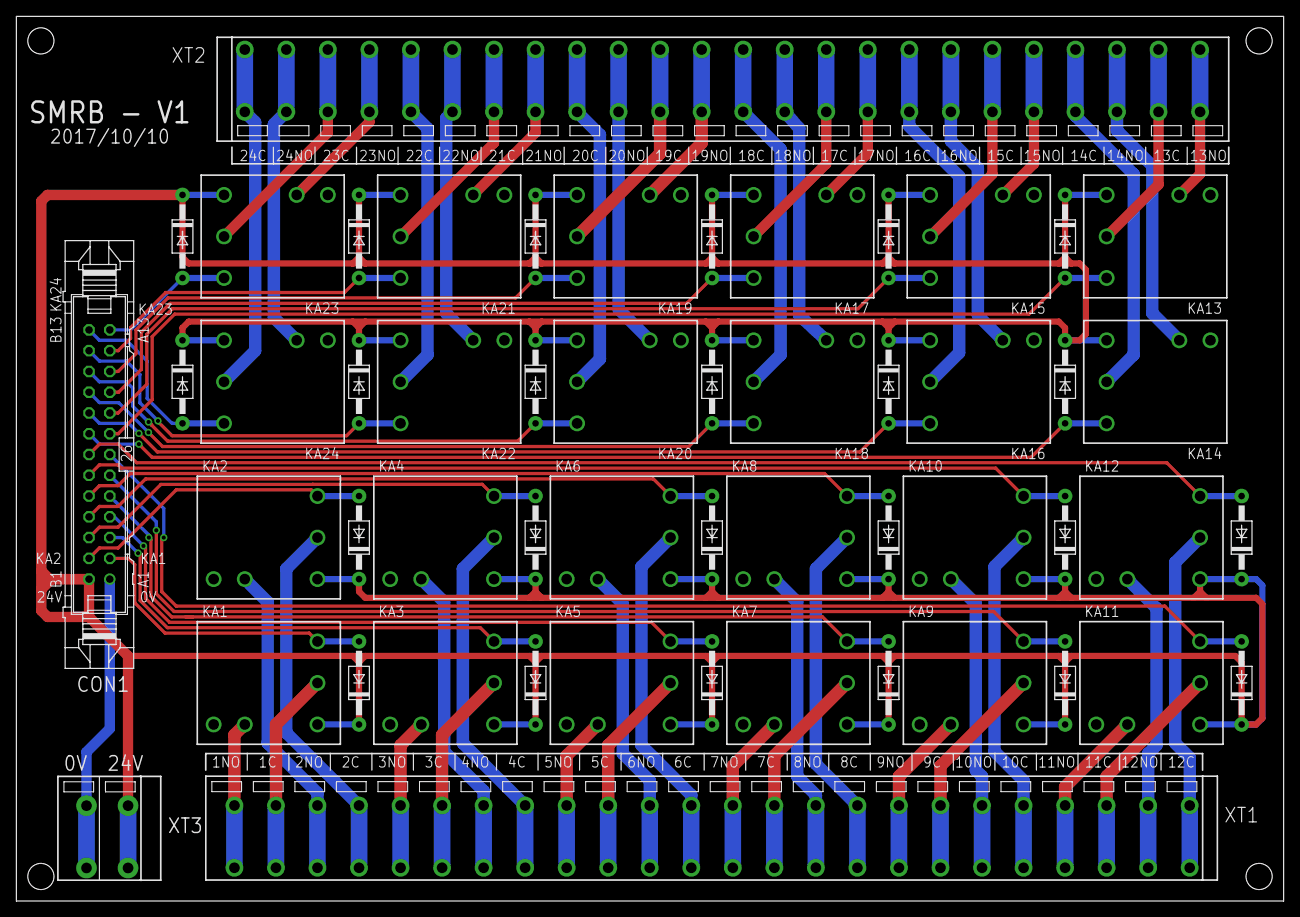
[picture p23: board SMR.brd from above]

Board: 2 copper layers, 155.0 x 108.2 mm, 54 parts (0 on the bottom side), 74 nets.

Other parts of the board:
U$1: 108.2-OUTLINE
