huayuliang/TEMP_FILE/snowmaker/APP/SnowMaker_V1.ioc

Mcu.UserName=STM32F103VCTx
PA0-WKUP.Signal=ADCx_IN0
PA1.Signal=ADCx_IN1
PA10.GPIO_Label=TLCMP-RX
PA10.Signal=USART1_RX
PA11.GPIO_Label=DOUT22
PA11.Signal=GPIO_Output
PA12.GPIO_Label=DOUT23
PA12.Signal=GPIO_Output
PA13.Signal=SYS_JTMS-SWDIO
PA14.Signal=SYS_JTCK-SWCLK
PA15.GPIO_Label=DOUT24
PA15.Signal=GPIO_Output
PA2.Signal=ADCx_IN2
PA3.Signal=ADCx_IN3
PA4.Signal=ADCx_IN4
PA5.Signal=ADCx_IN5
PA6.Signal=ADCx_IN6
PA7.Signal=ADCx_IN7
PA8.GPIO_Label=DOUT21
PA8.Signal=GPIO_Output
PA9.GPIO_Label=TLCMP-TX
PA9.Signal=USART1_TX
PB0.Signal=ADCx_IN8
PB1.Signal=ADCx_IN9
PB10.GPIO_Label=ETH_INT
PB10.Signal=GPIO_Input
PB11.GPIO_Label=ETH_RST
PB11.Signal=GPIO_Output
PB12.GPIO_Label=ETHSPI_NSS
PB12.Signal=SPI2_NSS
PB13.GPIO_Label=ETHSPI_SCK
PB13.Signal=SPI2_SCK
PB14.GPIO_Label=ETHSPI_MISO
PB14.Signal=SPI2_MISO
PB15.GPIO_Label=ETHSPI_MOSI
PB15.Signal=SPI2_MOSI
PB3.GPIO_Label=BTM-\!ATC
PB3.Signal=GPIO_Output
PB4.GPIO_Label=DOUT18
PB4.Signal=GPIO_Output
PB5.GPIO_Label=RTC-INT
PB5.Signal=GPIO_Input
PB6.GPIO_Label=RTC-SCL
PB6.Signal=I2C1_SCL
PB7.GPIO_Label=RTC-SDA
PB7.Signal=I2C1_SDA
PB8.GPIO_Label=DOUT19
PB8.Signal=GPIO_Output
PB9.GPIO_Label=DOUT20
PB9.Signal=GPIO_Output
PC0.Signal=ADCx_IN10
PC1.Signal=ADCx_IN11
PC10.GPIO_Label=DOUT15
PC10.Signal=GPIO_Output
PC11.GPIO_Label=DOUT16
PC11.Signal=GPIO_Output
PC12.GPIO_Label=DOUT17
PC12.Signal=GPIO_Output
PC13-TAMPER-RTC.Signal=GPIO_Output
PC14-OSC32_IN.Signal=GPIO_Output
PC15-OSC32_OUT.Signal=GPIO_Output
PC2.GPIO_Label=DIN17
PC2.Signal=GPIO_Input
PC3.GPIO_Label=DIN18
PC3.Signal=GPIO_Input
PC4.GPIO_Label=DIN19
PC4.Signal=GPIO_Input
PC5.GPIO_Label=DIN20
PC5.Signal=GPIO_Input
PC6.GPIO_Label=DOUT11
PC6.Signal=GPIO_Output
PC7.GPIO_Label=DOUT12
PC7.Signal=GPIO_Output
PC8.GPIO_Label=DOUT13
PC8.Signal=GPIO_Output
PC9.GPIO_Label=DOUT14
PC9.Signal=GPIO_Output
PD0.GPIO_Label=DOUT1
PD0.Signal=GPIO_Output
PD1.GPIO_Label=DOUT2
PD1.Signal=GPIO_Output
PD10.GPIO_Label=WI_RS485-R/W
PD10.Signal=GPIO_Output
PD11.GPIO_Label=DOUT6
PD11.Signal=GPIO_Output
PD12.GPIO_Label=DOUT7
PD12.Signal=GPIO_Output
PD13.GPIO_Label=DOUT8
PD13.Signal=GPIO_Output
PD14.GPIO_Label=DOUT9
PD14.Signal=GPIO_Output
PD15.GPIO_Label=DOUT10
PD15.Signal=GPIO_Output
PD2.GPIO_Label=DOUT3
PD2.Signal=GPIO_Output
PD3.GPIO_Label=DOUT4
PD3.Signal=GPIO_Output
PD4.GPIO_Label=DOUT5
PD4.Signal=GPIO_Output
PD5.GPIO_Label=BTM-TX
PD5.Signal=USART2_TX
PD6.GPIO_Label=BTM-RX
PD6.Signal=USART2_RX
PD7.GPIO_Label=BTM-LINK
PD7.Signal=GPIO_Input
PD8.GPIO_Label=WI_RS485-TX
PD8.Signal=USART3_TX
PD9.GPIO_Label=WI_RS485-RX
PD9.Signal=USART3_RX
PE0.GPIO_Label=DIN1
PE0.Signal=GPIO_Input
PE1.GPIO_Label=DIN2
PE1.Signal=GPIO_Input
PE10.GPIO_Label=DIN11
PE10.Signal=GPIO_Input
PE11.GPIO_Label=DIN12
PE11.Signal=GPIO_Input
PE12.GPIO_Label=DIN13
PE12.Signal=GPIO_Input
PE13.GPIO_Label=DIN14
PE13.Signal=GPIO_Input
PE14.GPIO_Label=DIN15
PE14.Signal=GPIO_Input
PE15.GPIO_Label=DIN16
PE15.Signal=GPIO_Input
PE2.GPIO_Label=DIN3
PE2.Signal=GPIO_Input
PE3.GPIO_Label=DIN4
PE3.Signal=GPIO_Input
PE4.GPIO_Label=DIN5
PE4.Signal=GPIO_Input
PE5.GPIO_Label=DIN6
PE5.Signal=GPIO_Input
PE6.GPIO_Label=DIN7
PE6.Signal=GPIO_Input
PE7.GPIO_Label=DIN8
PE7.Signal=GPIO_Input
PE8.GPIO_Label=DIN9
PE8.Signal=GPIO_Input
PE9.GPIO_Label=DIN10
PE9.Signal=GPIO_Input
