huayuliang/TEMP_FILE/(commit log)

2017-10-10 SMRB complete
    [SMR.brd, SMR.sch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]
2017-10-10 PI fisrt commit
    [PannelInterface.brd, PannelInterface.sch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]
2017-10-11 PI change
    [PannelInterface.brd]
